Sierra-Lobo/backplane/revC1/doc/backplane-top.jpg

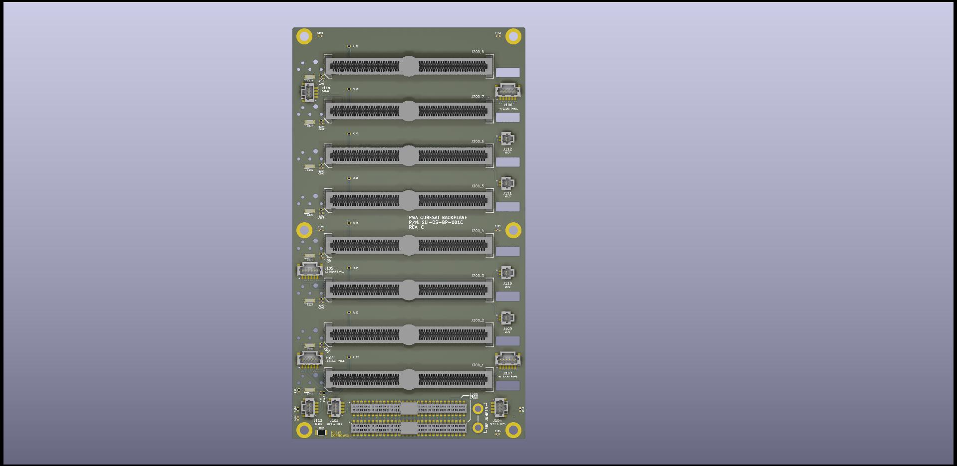
revC1/doc/backplane-top.jpg
