Sierra-Lobo/backplane/revC/pdf/backplane_brd.jpg

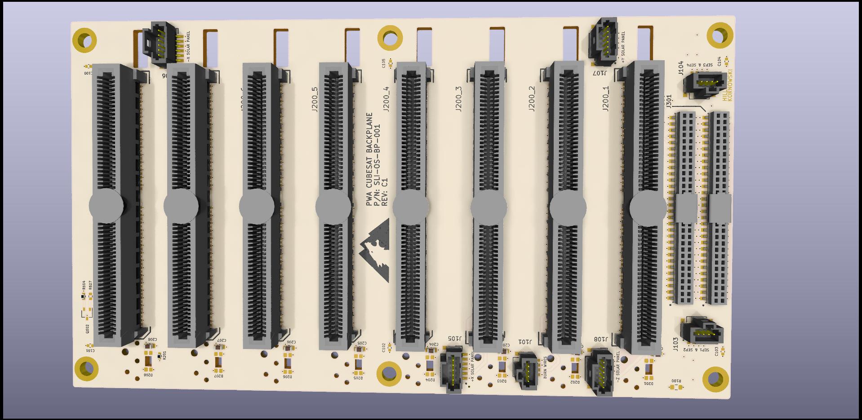
revC/pdf/backplane_brd.jpg
