Sierra-Lobo/backplane/README.md

# backplane

Sierra Lobo's 1.5U Cubesat Backplane
