Sierra-Lobo/backplane/revC/gerbers/settings.PNG

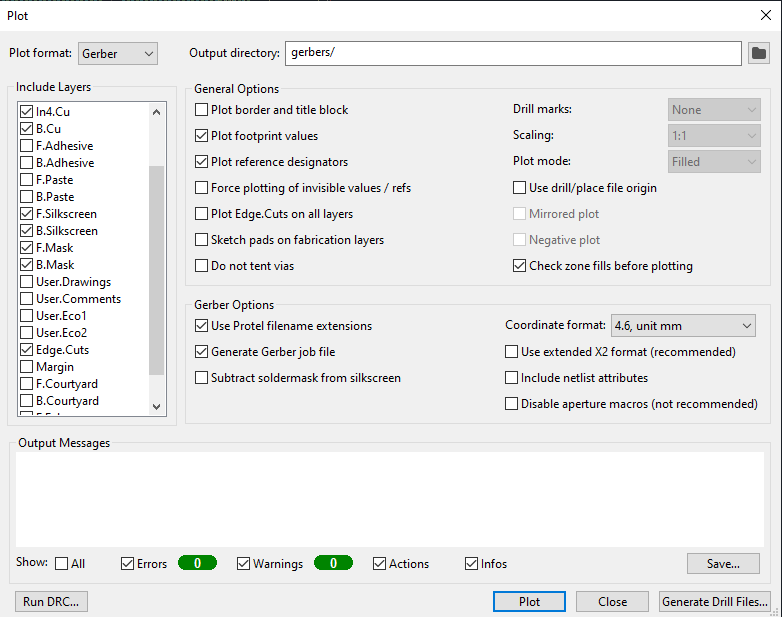
revC/gerbers/settings.PNG
