Sierra-Lobo/backplane/revC/gerbers/settings_drl.PNG

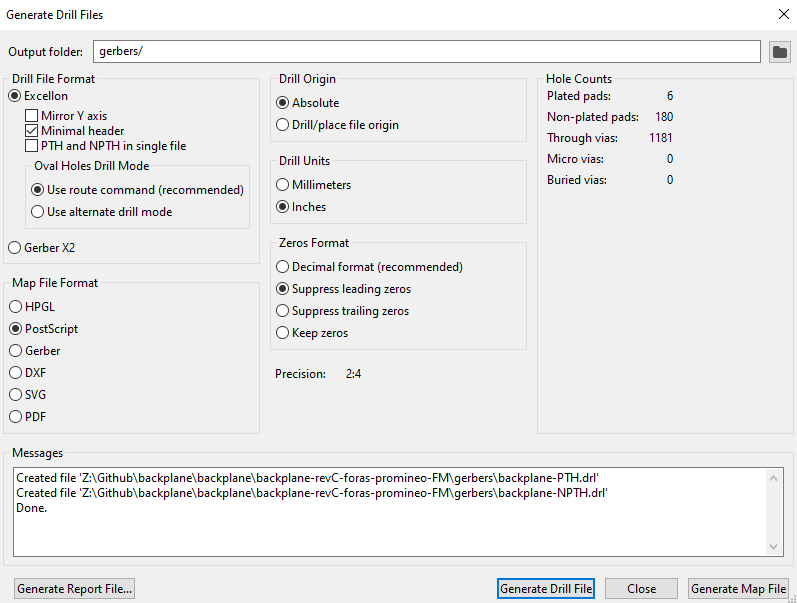
revC/gerbers/settings_drl.PNG
