Sierra-Lobo/backplane/revC1/doc/bom.xlsx

Date: | 2023-05-31
Components: | 69
Item | Qty | Designator | Description | LibPart | Footprint | Manufacturer | Manufacturer Part Number | DNP Flight | DNP Test | Populated By Vendor | Populated by SLI | Comment
1 | 1 |  | RBF Jumper | SierraLobo:BOMTIE |  | Keystone Electronics | 1430-2 |  |  |  | X
2 | 6 | C100, C101, C102, C103, C104, C105 | 10nF | backplane-rescue:C-Device | Capacitor_SMD:C_0402_1005Metric | TDK | CGA2B3X7S2A103K050BB |  |  | X
3 | 8 | C201, C202, C203, C204, C205, C206, C207, C208 | 0.1uF | Device:C | Capacitor_SMD:C_0402_1005Metric | TDK | CGA2B3X7R1E104K050BB |  |  | X
4 | 8 | D201, D202, D203, D204, D205, D206, D207, D208 |  | CubeSat_Backplane:SK68xx | SierraLobo:SK68xx-EC120x_ReverseMount | Adafruit | SK6812-EC321F |  |  |  | X | reverse mounted
5 | 4 | J103, J104, J113, J114 |  | Connector_Generic:Conn_01x04 | SierraLobo:SAMTEC_T1M-04-F-SV-L | Samtec | T1M-04-F-SV-L |  |  | X
6 | 4 | J105, J106, J107, J108 |  | Connector_Generic:Conn_01x06 | SierraLobo:SAMTEC_T1M-06-F-SV-L | Samtec | T1M-06-F-SV-L |  |  | X
7 | 4 | J109, J110, J111, J112 |  | Connector_Generic:Conn_01x02 | SierraLobo:SAMTEC_T1M-02-F-SV-L-P | Samtec | T1M-02-F-SV-L |  |  | X
8 | 8 | J200_1, J200_2, J200_3, J200_4, J200_5, J200_6, J200_7, J200_8 |  | CubeSat_Backplane:Conn_02x60_Top_Bottom | SierraLobo:HTEC8-160-01-S-DV-A-K-TR | Samtec | HTEC8-160-01-L-DV-A |  |  | X
9 | 2 | J300, J301 |  | backplane-rescue:Conn_02x30_Odd_Even-Connector_Generic | SierraLobo:SAMTEC_CLP-130-02-X-D-BE-A-P-TR | Samtec | CLP-130-02-X-D-BE-A-P-TR |  |  |  | X
10 | 2 | P100, P101 |  | Connector_Generic:Conn_01x01 | SierraLobo:MilMax_0640-0 | MilMax | 0640-0-15-15-48-27-10-0 |  |  |  | X | Press fit mounted
11 | 1 | R100 | 0R | backplane-rescue:R_US-Device | Resistor_SMD:R_1206_3216Metric | Keystone Electronics | Keystone 5108 |  |  | X
12 | 11 | R101, R102, R103, R104, R105, R106, R107, R108, R109, R111, R112 | 0R | backplane-rescue:R_US-Device | Resistor_SMD:R_0402_1005Metric | Panasonic | ERJ-2GE0R00X | R111, R112 |  | X
13 | 8 | R203, R204, R205, R206, R207, R208, R209, R210 | 1k | :R_US-Device_1 | Resistor_SMD:R_0402_1005Metric | Panasonic | ERJ-2GEJ102X | R210 |  | X
14 | 2 | SW100, SW101 | RESET | backplane-rescue:SW_Push-Switch | SierraLobo:KMT031_NGJ_LHS | C&K | KMT031NGJLHS |  |  | X
