Sierra-Lobo/backplane/revC/bom/backplane_bom.xlsx

Item | Qty | Reference(s) | Value | Part Number | Mfr | Note
1 | 6 | C100, C101, C102, C103, C104, C105 | 0.1uF 0402 | C0402C104M4RACAUTO | KEMET
2 | 8 | C201, C202, C203, C204, C205, C206, C207, C208 | 1uF 0603 | C0603C105K8RACAUTO | KEMET
3 | 8 | D201, D202, D203, D204, D205, D206, D207, D208 | RGB LED 3210 | SK68XX-EC3210R | Adafruit | mount upside-down
4 | 3 | J101, J103, J104 | Conn 4 pos | T1M-04-F-SV-L | Samtec
5 | 4 | J105, J106, J107, J108 | Conn 6 pos | T1M-06-F-SV-L | Samtec
6 | 8 | J200_1, J200_2, J200_3, J200_4, J200_5, J200_6, J200_7, J200_8 | Card Edge Connector, 120 | HSEC8-160-01-S-DV-A-K-TR | Samtec
7 | 2 | J300, J301 | Header 30x2 | CLP-130-02-X-D-BE-A-P-TR | Samtec
8 | 2 | Q602, Q603 | PNP SOT323 | BC857AW,115 | Nexperia
9 | 1 | R100 | 0mR | RC0603JR-070RL | YAEGO | DNP
10 | 1 | R201 | 330R | RMCF0402JT330R | YAEGO
11 | 1 | R604 | 0R | RMCF0402ZT0R00 | YAEGO
12 | 2 | R607, R609 | 4.7k | RMCF0402FT4K70 | YAEGO
13 | 1 | R608 | 10k | RMCF0402FT10K0 | YAEGO
14 | 2 | SW100, SW101 | SMT SW | KMT031NGJLHS | C&K
