Sierra-Lobo/backplane/revC/fabrication-data/PCBway-TZ28W422300A-2sets-backplane_bom(2022-05-12).xls

PCBWay Bom Quotation, Product No.:T-Z28W422300A
Item # | *Designator | *Qty | Manufacturer | *Mfg Part # | Description / Value | *Package/Footprint | Your Instructions / Notes | *Unit Price(2 sets) | *Total | *Delivery Time | *PCBWay Note | Customer Reply | PCBWay Update
1 | C100,C101,C102,C103,C104,C105 | 6 | KEMET | C0402C104M4RACAUTO | 0.1uF | 0402（1005 metric） |  | $0.140 | $1.680
2 | C201,C202,C203,C204,C205,C206,C207,C208 | 8 | KEMET | C0603C105K8RACAUTO | 1uF | 0603（1608 metric） |  | $0.138 | $2.208
3 | D201,D202,D203,D204,D205,D206,D207,D208 | 8 |  | SK68XX-EC3210R |  |  | mount upside-down |  |  |  | [It's out of stock. Please recommend substitutes or you can supply this part to us.] | Do not place
4 | J101,J103,J104 | 3 | Samtec Inc. | T1M-04-F-SV-L |  |  |  | $4.094 | $24.564 | 7-10 Workdays
5 | J105,J106,J107,J108 | 4 | Samtec Inc. | T1M-06-F-SV-L |  |  |  | $8.161 | $65.288 | 15 Workdays
6 | J200_1,J200_2,J200_3,J200_4,J200_5,J200_6,J200_7,J200_8 | 8 | Samtec Inc. | HSEC8-160-01-S-DV-A-K-TR |  |  |  | $9.290 | $148.640 | 7-10 Workdays
7 | J300,J301 | 2 | Samtec Inc. | CLP-130-02-X-D-BE-A-P-TR |  |  |  |  |  |  | [It's out of stock. Please recommend substitutes or you can supply this part to us.] | Do not place
8 | Q602,Q603 | 2 | Nexperia USA Inc. | BC857AW,115 |  | SC-70，SOT-323 |  | $0.232 | $0.928 | 7-10 Workdays
9 | R100 | 1 | YAGEO | RC0603JR-070RL | 0mR | 0603（1608 metric） | DNP | $0.069 | $0.138
10 | R201 | 1 | Stackpole Electronics Inc | RMCF0402JT330R | 330R | 0402（1005 metric） |  | $0.069 | $0.138
11 | R604 | 1 | Stackpole Electronics Inc | RMCF0402ZT0R00 | 0R | 0402（1005 metric） |  | $0.069 | $0.138
12 | R607,R609 | 2 | Stackpole Electronics Inc | RMCF0402FT4K70 | 4.7k | 0402（1005 metric） |  | $0.058 | $0.232
13 | R608 | 1 | Stackpole Electronics Inc | RMCF0402FT10K0 | 10k | 0402（1005 metric） |  | $0.069 | $0.138
14 | SW100,SW101 | 2 | C&K | KMT031NGJLHS |  |  |  | $1.575 | $6.300
 |  |  |  |  |  |  |  | All Total | $250.392
