Sierra-Lobo/backplane/backplane-boards/backplane-breakout-big/backplane-breaout-big.step

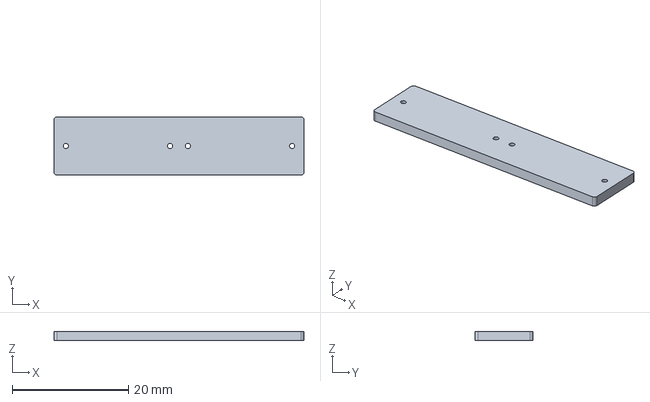
[picture p5: CAD file, 2021-12-19]
backplane-boards/backplane-breakout-big/backplane-breaout-big.step
43.0 x 10.0 x 1.60 mm
