Sierra-Lobo/backplane/revC/solid models/SAMTEC-FTS-130-03-X-DV.step

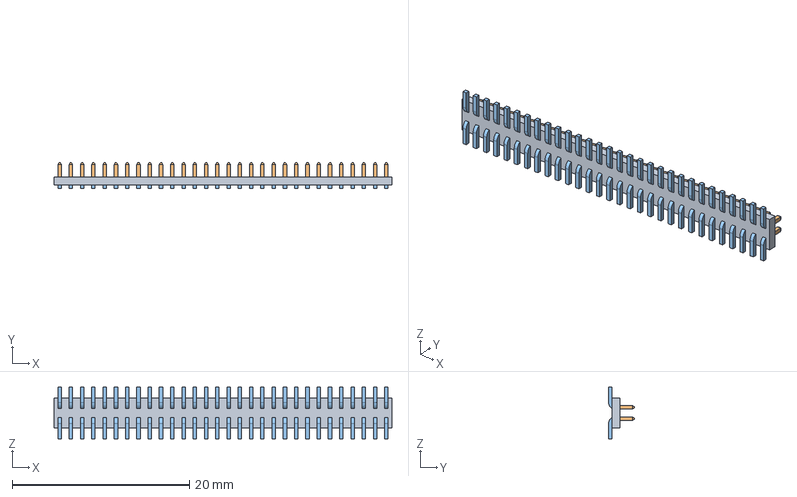
[picture p6: CAD file, 2021-12-21]
revC/solid models/SAMTEC-FTS-130-03-X-DV.step
38.1 x 2.92 x 5.84 mm
_FTS-130-03-L-DV_body
_FTS-130-03-L-DV_pins1
_FTS-130-03-L-DV_pins2
