Sierra-Lobo/backplane/solid models/backplane.step

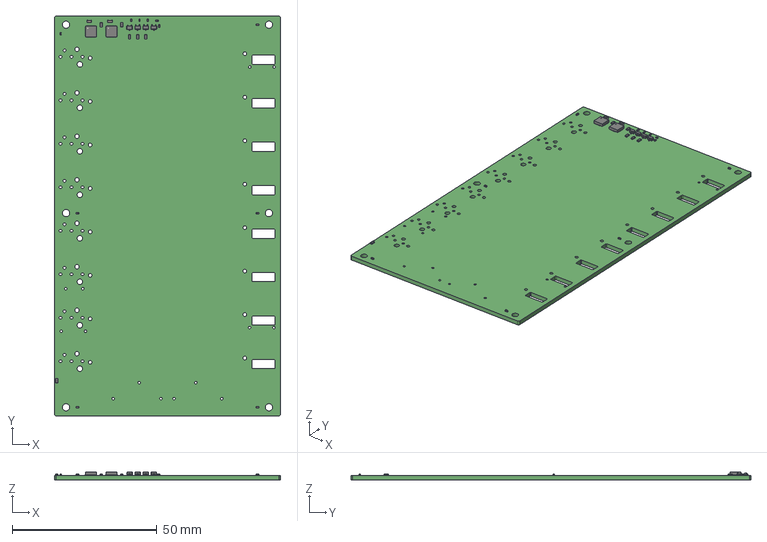
[picture p7: CAD file, 2021-12-17]
solid models/backplane.step
78.0 x 138.0 x 2.75 mm
