Sierra-Lobo/backplane/revC/fabrication-data/AA B110353 ER.xlsx

BOM LINE | MFG PN | ISSUE | RESOLUTION
7 | CLP-130-02-X-D-BE-A-P-TR | Please confirm PN, stock not found | We can supply these
5 | T1M-06-F-SV-L | 89 days lead time. | substitute T1M-06-F-SV-L-P please.
 | SUB APPROVAL REQUIRED
BOM LINE | MFG PN | SUGGESTED ALT | ALT LT IF APPLICABLE | RESOLUTION
3 | SK68XX-EC3210R | 4893 | 14 days lead time. | DNP please
