Sierra-Lobo/backplane/revB/fabrication-data/backplane_log.xlsx

Sheet: Changes too
Make manufacturer put no solder on unused pads
Make manufacturer assemble all parts even if we have to cosign them, these boards are challenging to assemble
make sure J300, J301 are placed next time
Move R100 farther from board edge

Sheet: FP-P-01
Board Location: | SLI TDEC in Foras Promineo ESD tote
Date | Action | Comment | Date | Todo | Comment
2022-02-16 | Received |  | 2022-02-17
2022-02-17 | Removed all unused pads’ solder
2022-02-17 | Failed solder J300, removed it and ordered more

Sheet: FP-P-02
Board Location: | Caden
Date | Action | Comment | Date | Todo | Comment
2022-02-16 | Received |  | 2022-02-17
2022-02-17 | Removed all unused pads’ solder
2022-02-17 | Soldered on J300, J301 but rear mount header (part of backplane breakout connector) was used to allign it and was also soldered to the board.
