Sierra-Lobo/backplane/revB/fabrication-data/PCBway/W422300AS1J11.xls

Sheet: EQs
EQ
ITEM | QUESTION | ADVICE | PICTURE | REPLY | REMARK
1 | Attention 1.jpg,please confirm if the stackup information is OK. | ok | 1.jpg | OK
2 | Attention 2.jpg,two files at the arrow cannot be opened, please confirm | Ignore these 2 files,tolerance for all PTH holes: +/-3mil; NPTH hole tolerance: +/-2mil,OK? | 2.jpg | OK
3 | Please confirm if the attached working file is OK. | ok |  | OK

Sheet: 1.jpg
返回（Return） EQs

Sheet: 2.jpg
返回（Return） EQs
