Sierra-Lobo/backplane/(threads)

Thread 1 (2021-12-17):

add burn wire connectors

cadenhillis, 2021-12-17:

cadenhillis, 2022-05-10:
see RevC :)

Closed 2022-05-10.
