Sierra-Lobo/backplane/revC1/doc/backplane_assy.pdf

R209 | R109 C²⁰¹ C203
R210 R²⁰³ | R103

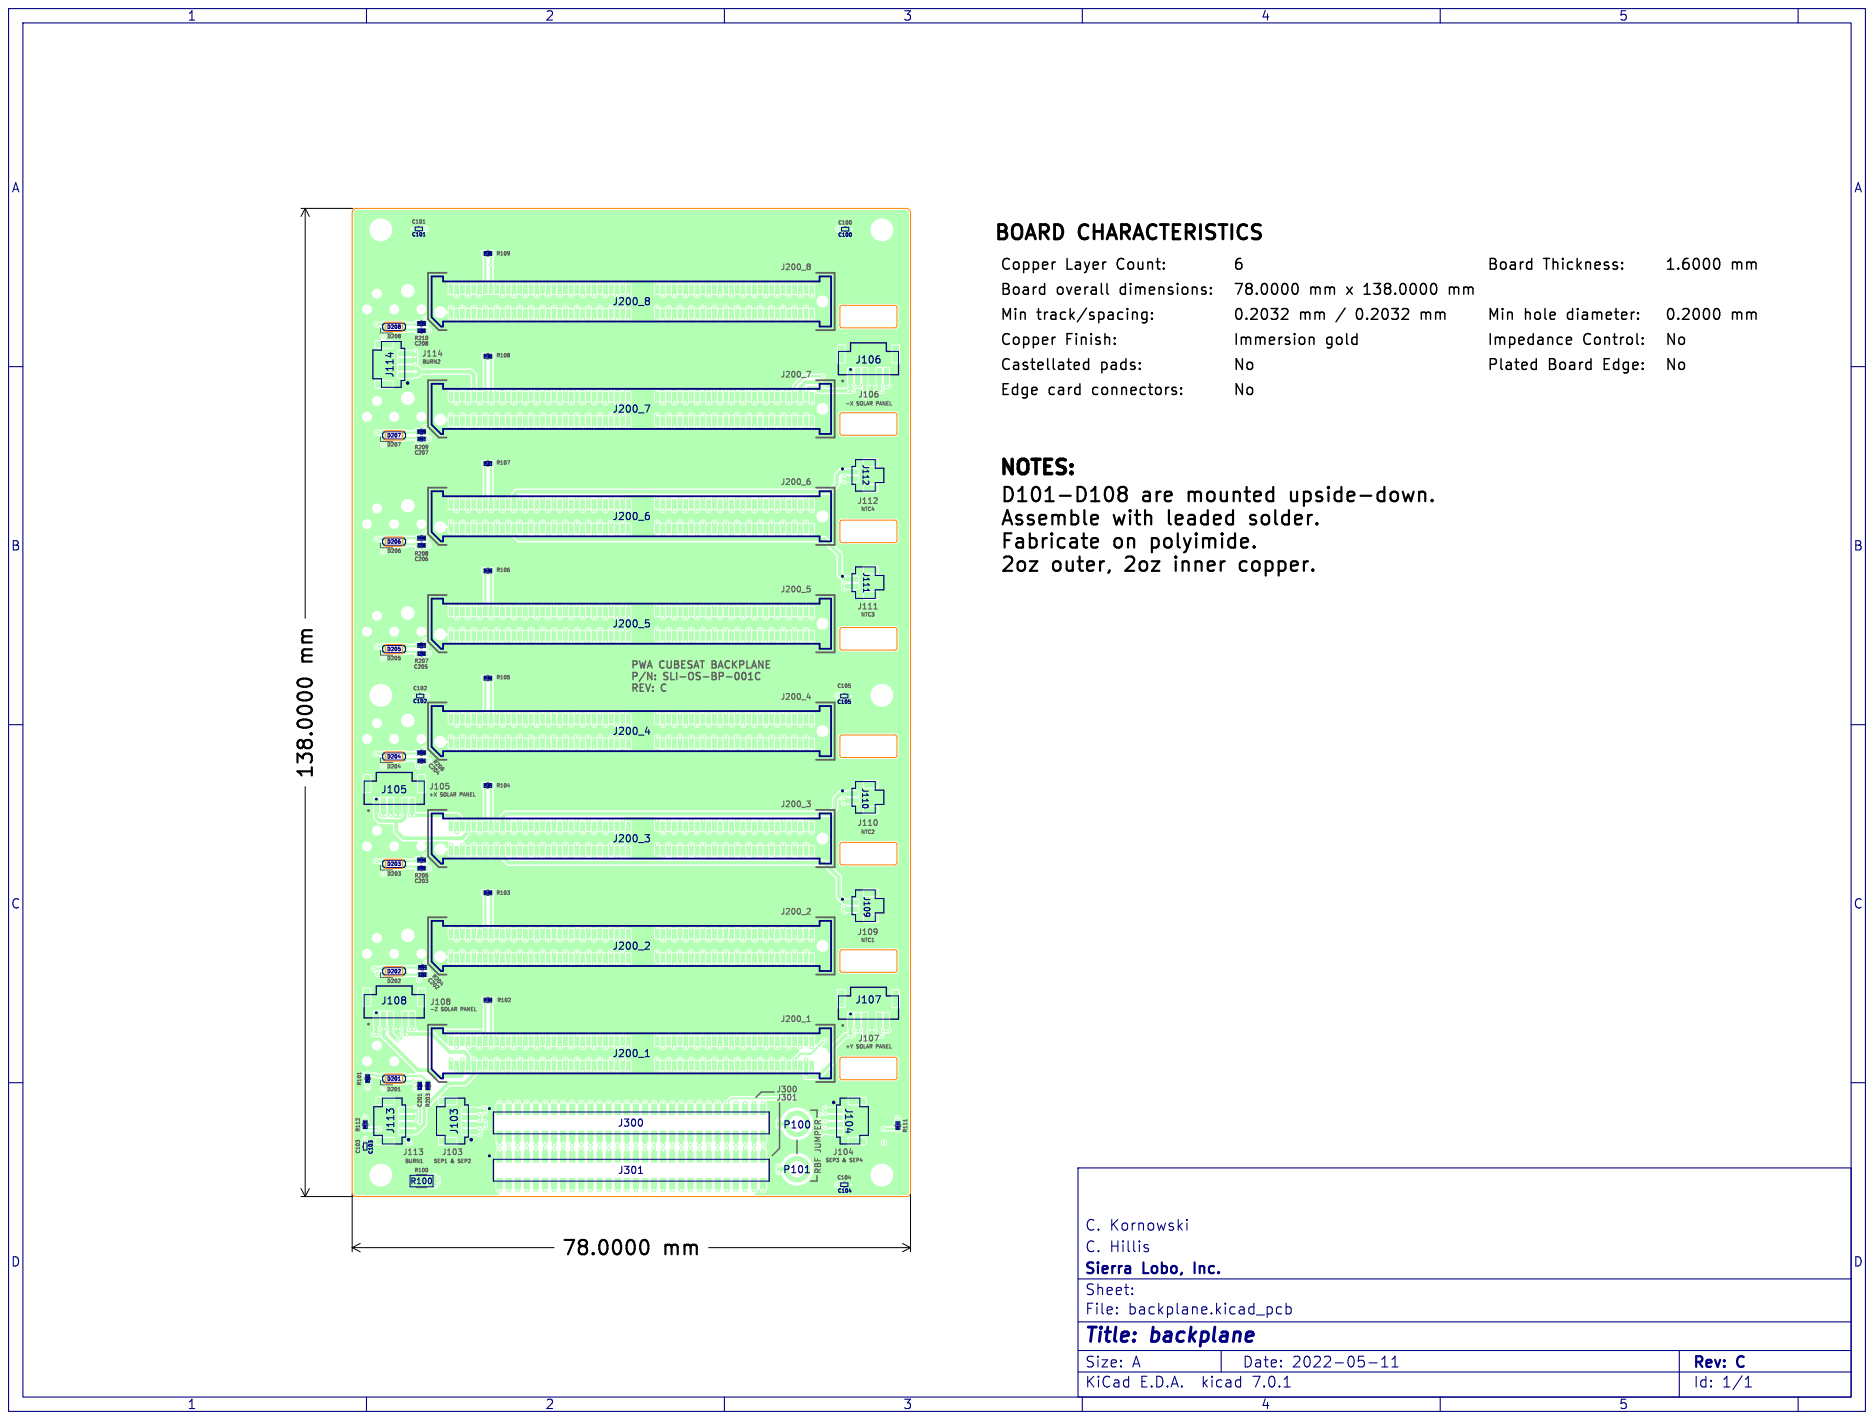
[picture p8: page 1]

File: backplane.kicad_pcb Sheet: Sierra Lobo, Inc. C. Hillis C. Kornowski J110 J109 J112 J111

2oz outer, 2oz inner copper. 138.0000 mm

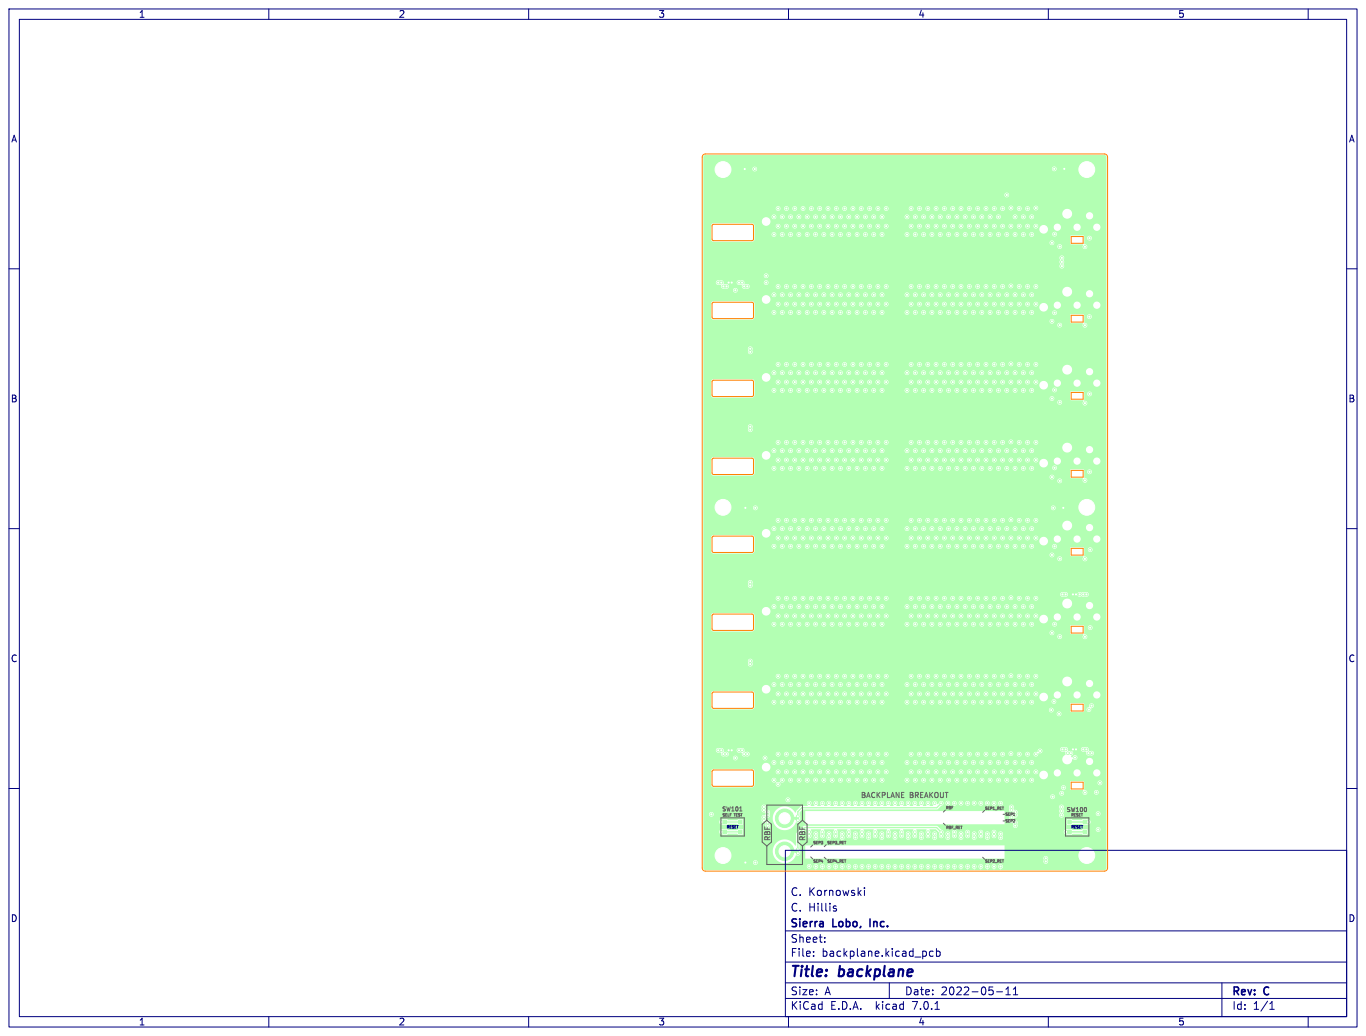
[picture p9: page 2]
D Date: 2022-05-11 KiCad; kicad; 7.0.1 Size: A; Rev: C; File:; backplane.kicad_pcb Sheet: Sierra; Lobo,; Inc. C.; Hillis C.; Kornowski RESET; RESET

Id: 1/1 Title: backplane
