Sierra-Lobo/backplane/revC/pdf/backplane-sch.pdf

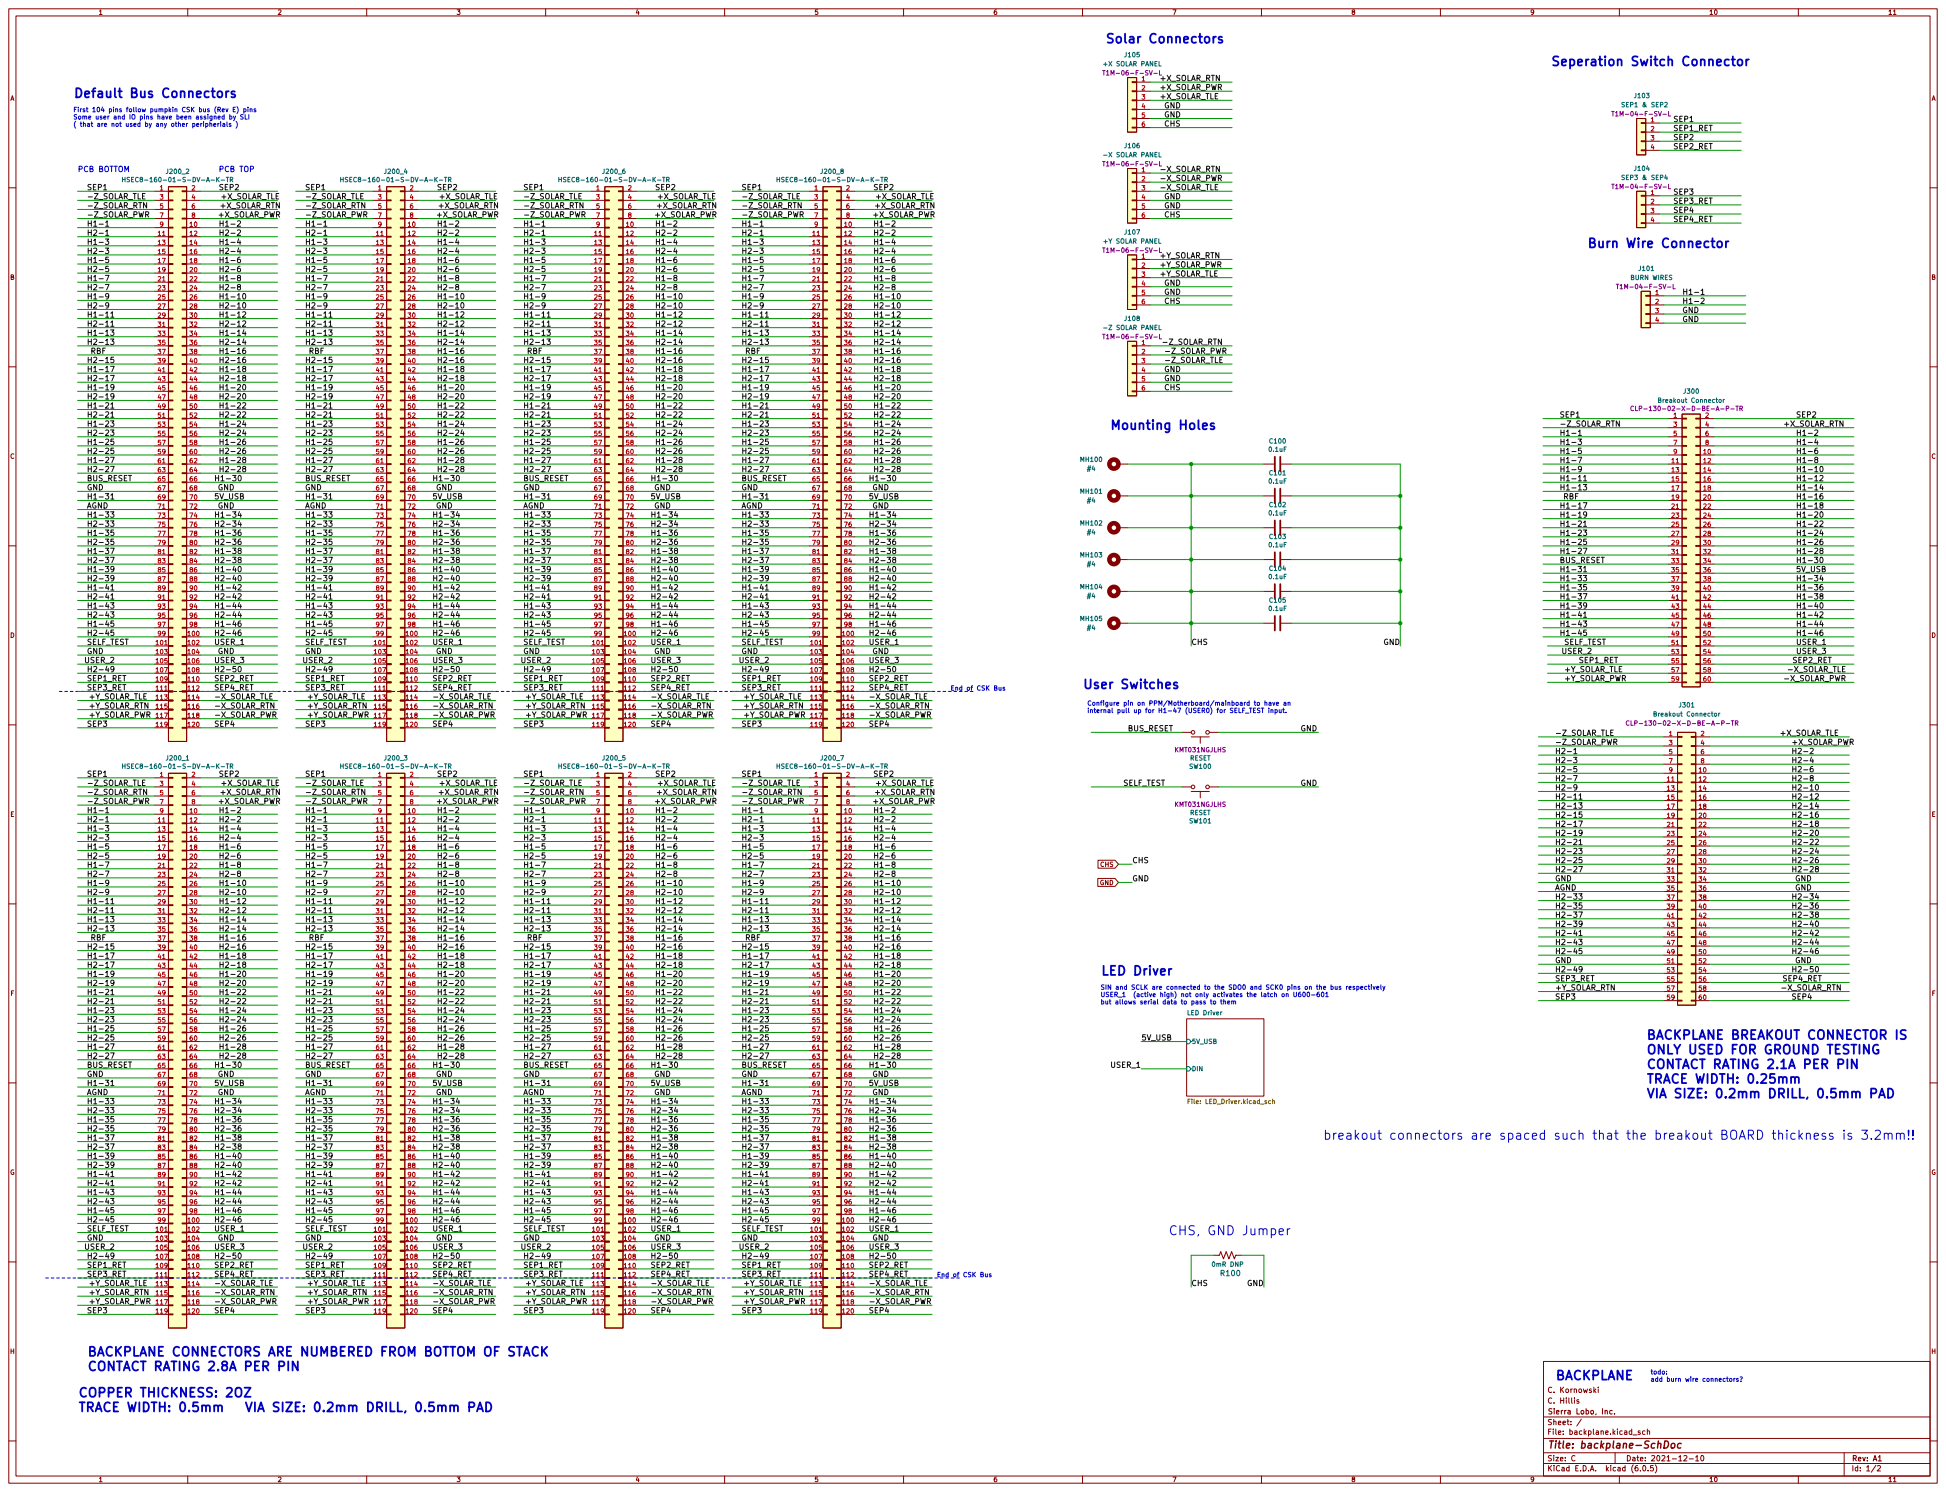
[picture p10: page 1]

First 104 pins follow pumpkin CSK bus (Rev E) pins
Some user and IO pins have been assigned by SLI
( that are not used by any other peripherials )

J300 Breakout Connector CLP-130-02-X-D-BE-A-P-TR
H1-1 H1-5 H1-41 H1-37 H1-43 H1-27 H1-31 BUS_RESET H1-45 H1-39 SELF_TEST H1-25 H1-19SEP1_RET

Configure pin on PPM/Motherboard/mainboard to have an
internal pull up for H1-47 (USER0) for SELF_TEST input.

J301 Breakout Connector CLP-130-02-X-D-BE-A-P-TR R100

SIN and SCLK are connected to the SDO0 and SCK0 pins on the bus respectively
USER_1 (active high) not only activates the latch on U600-601
but allows serial data to pass to them

BACKPLANE BREAKOUT CONNECTOR IS
ONLY USED FOR GROUND TESTING
CONTACT RATING 2.1A PER PIN
TRACE WIDTH: 0.25mm
VIA SIZE: 0.2mm DRILL, 0.5mm PAD

breakout connectors are spaced such that the breakout BOARD thickness is 3.2mm!!

BACKPLANE CONNECTORS ARE NUMBERED FROM BOTTOM OF STACK
CONTACT RATING 2.8A PER PIN
COPPER THICKNESS: 2OZ
TRACE WIDTH: 0.5mm VIA SIZE: 0.2mm DRILL, 0.5mm PAD

File: backplane.kicad_sch Sheet: / Sierra Lobo, Inc. C. Hillis C. Kornowski

Id: 1/2 Title: backplane-SchDoc

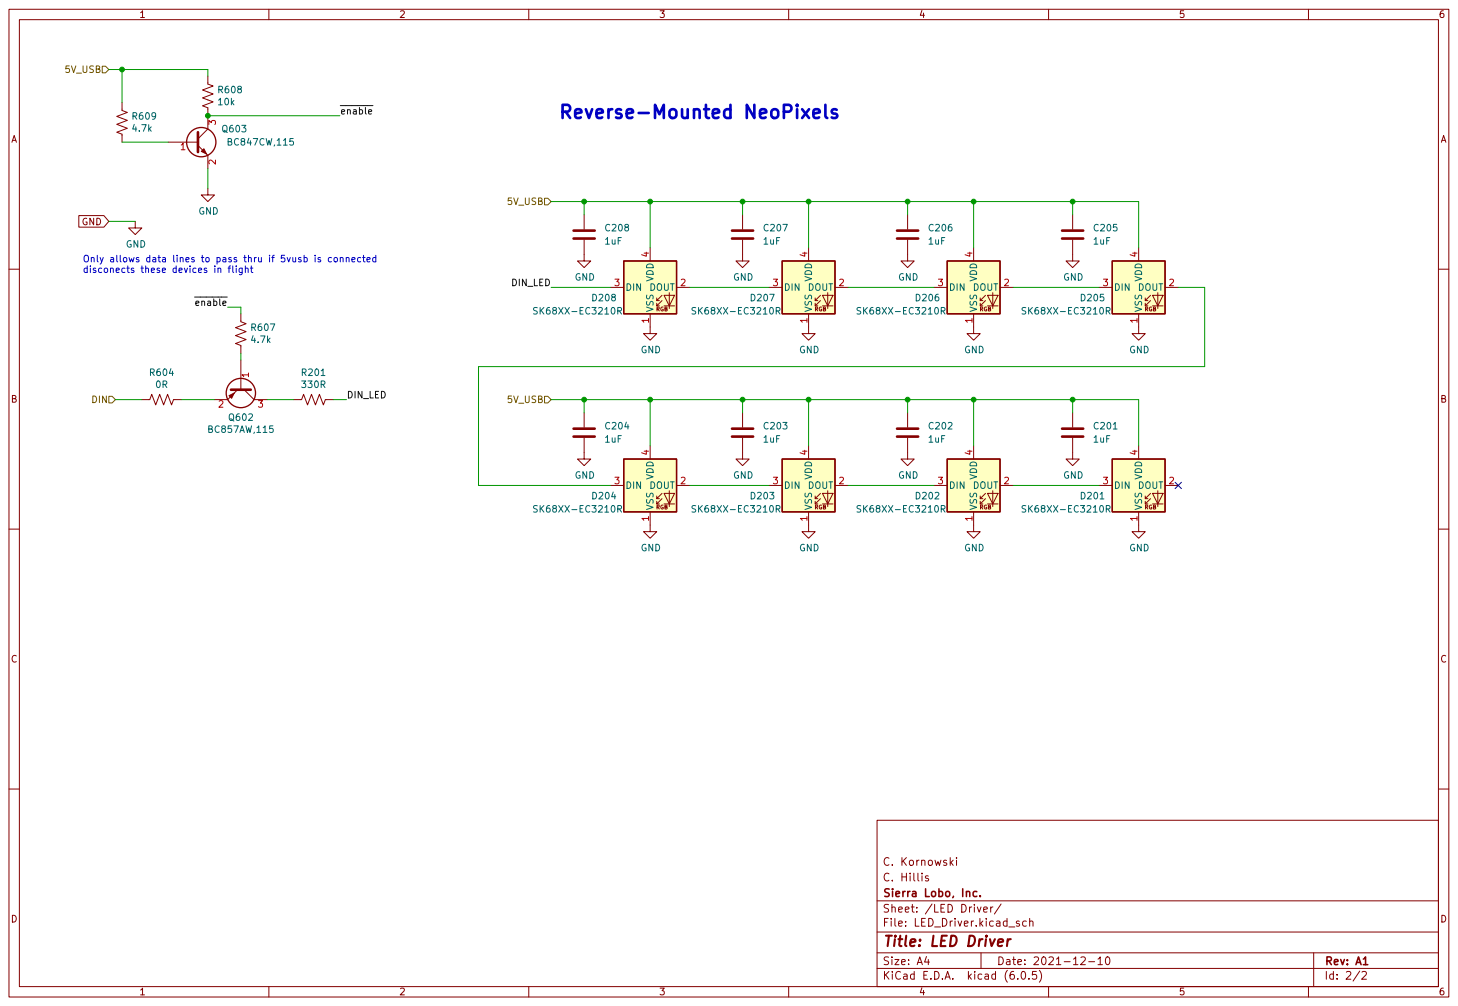
[picture p11: page 2]

DIN_LED Only allows data lines to pass thru if 5vusb is connected
disconects these devices in flight

4 D208 SK68XX-EC3210R VSS RGB 1 DOUT 2 DIN 3 VDD

4 D204 SK68XX-EC3210R GND GND GND VSS RGB 1 DOUT 2 DIN 3 VDD

4 D202 SK68XX-EC3210R GND VSS RGB 1 DOUT 2 DIN 3 VDD

4 D203 SK68XX-EC3210R VSS RGB 1 DOUT 2 DIN 3 VDD

Id: 2/2 Title: LED Driver
