Sierra-Lobo/backplane/revC1/doc/backplane-sch.pdf

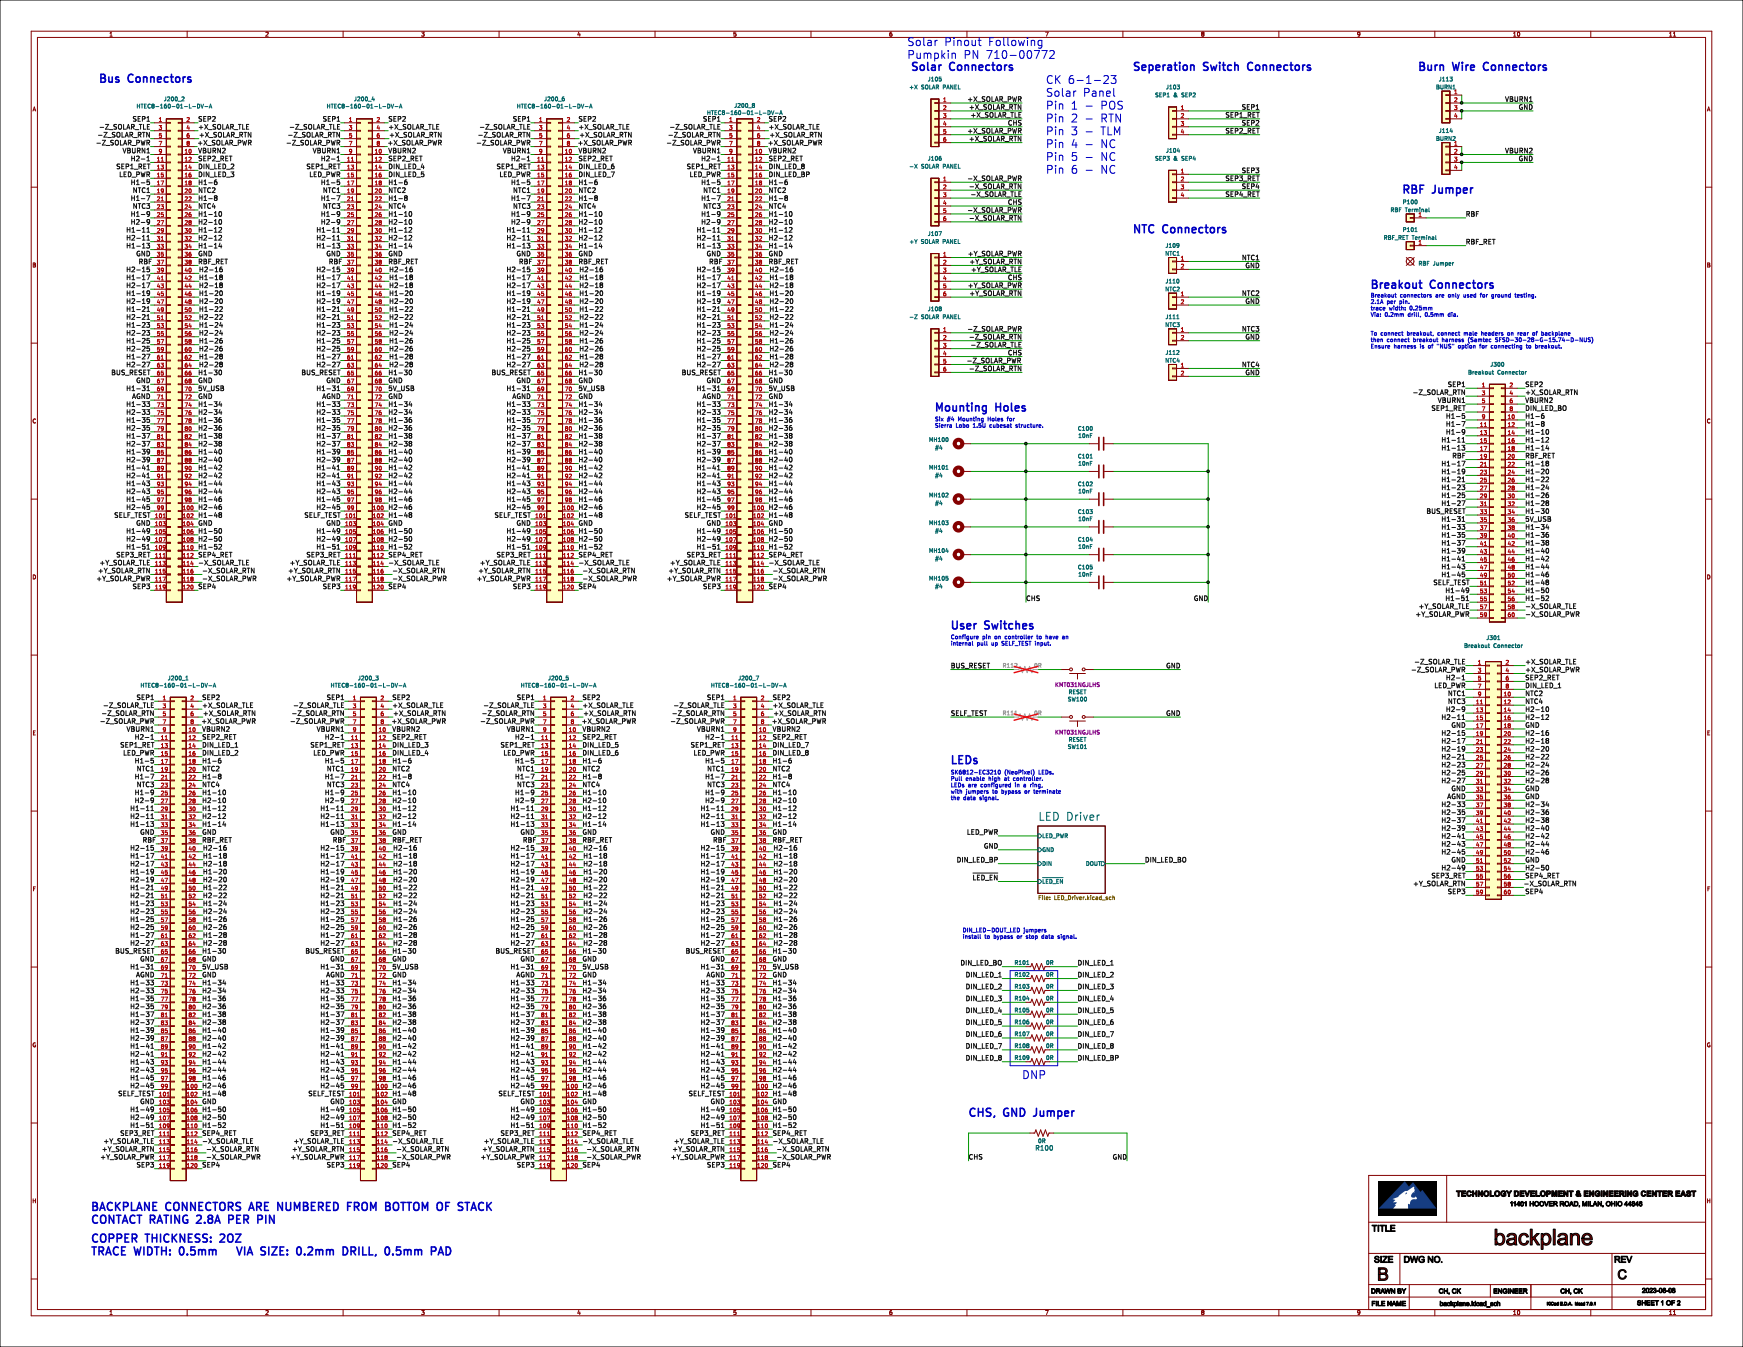
[picture p12: page 1]

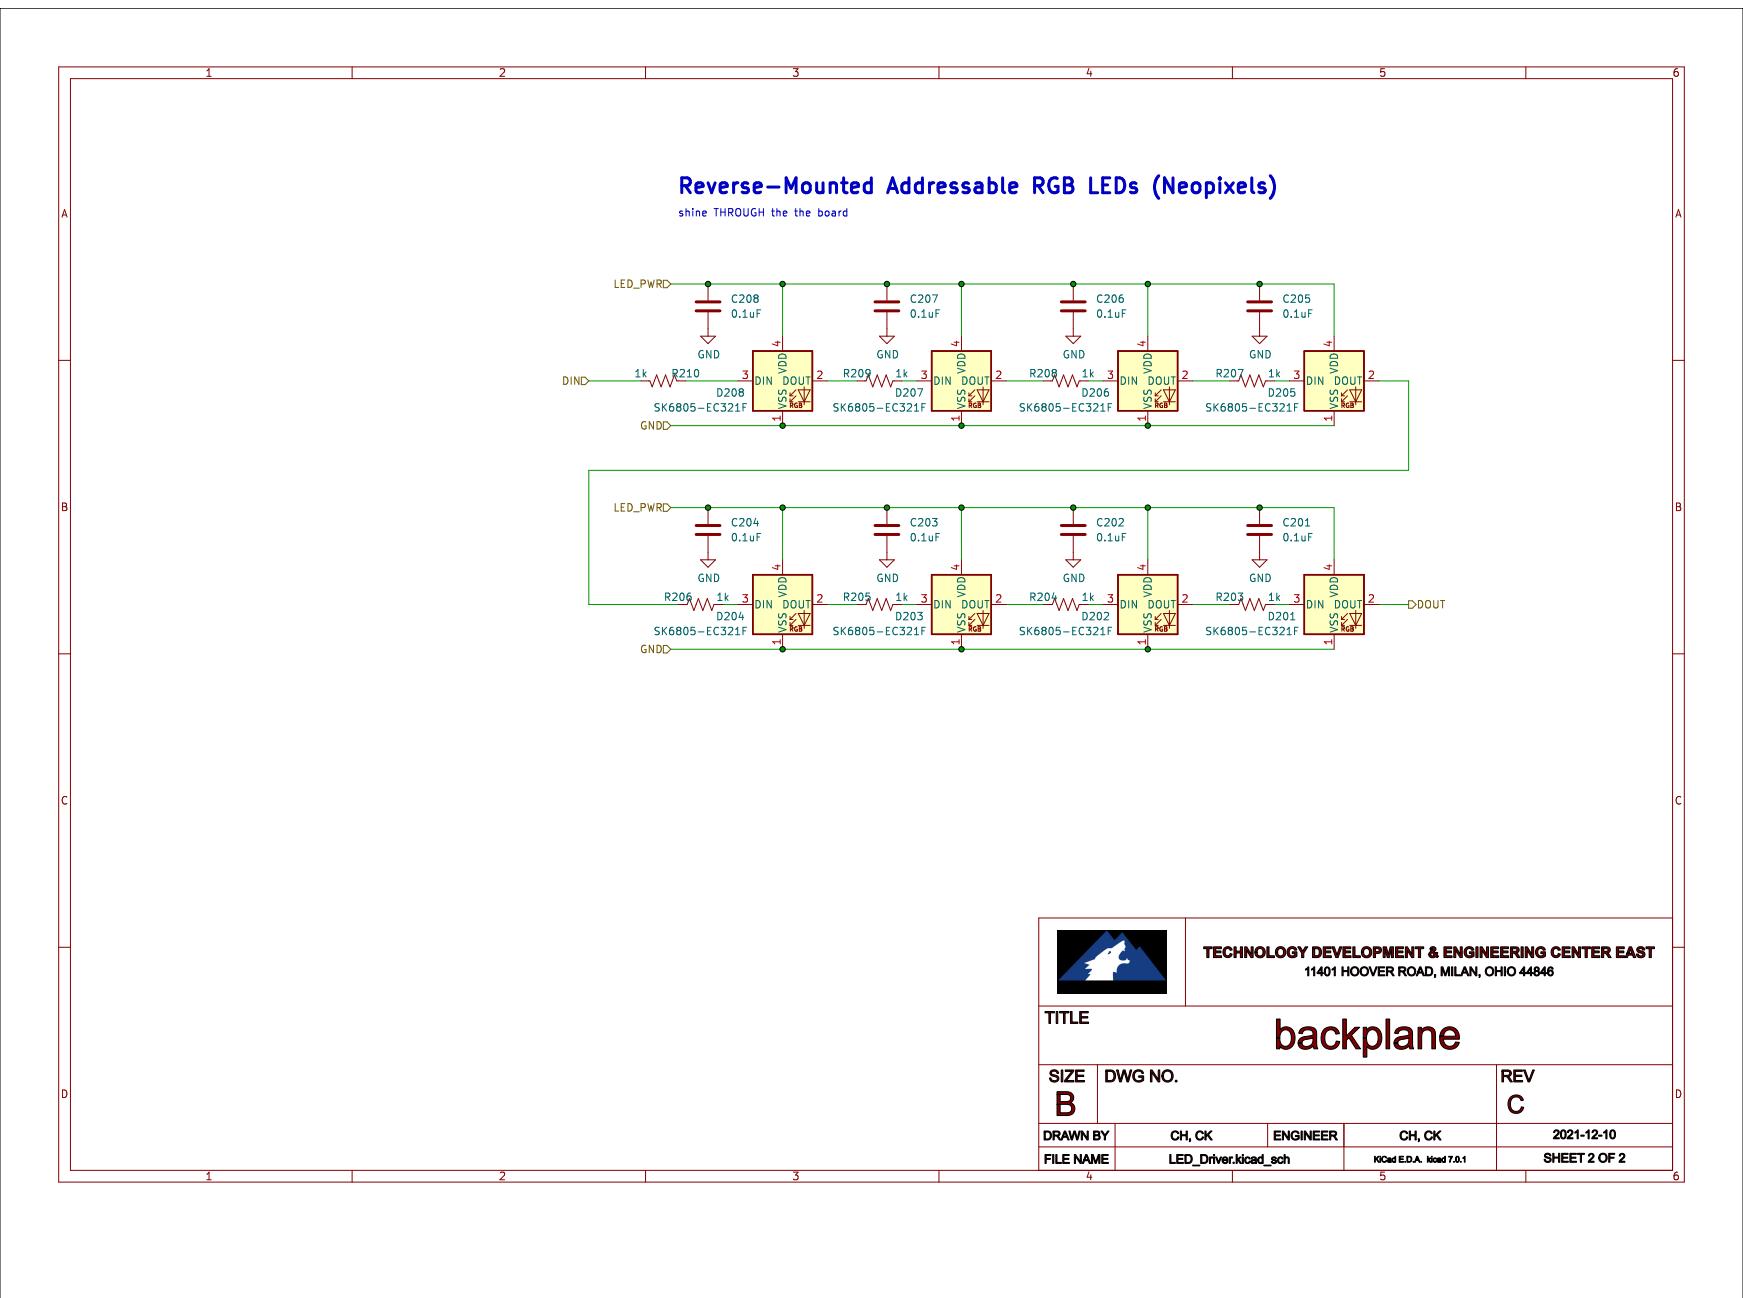
[picture p13: page 2]
