Sierra-Lobo/backplane/revC/pdf/backplane-brd.pdf

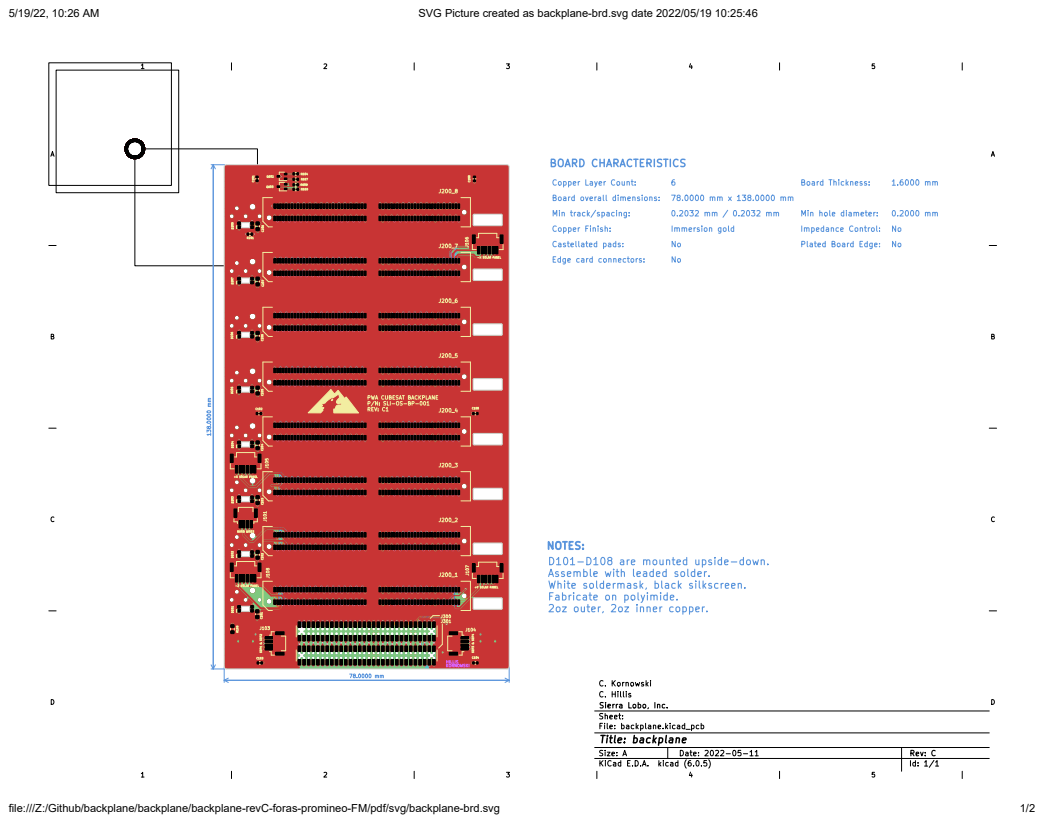
[picture p14: page 1]
SVG Picture created as backplane-brd.svg date 2022/05/19 10:25:46; file:///Z:/Github/backplane/backplane/backplane-revC-foras-promineo-FM/pdf/svg/backplane-brd.svg
