Sierra-Lobo/backplane/revB/pdf/backplane.pdf

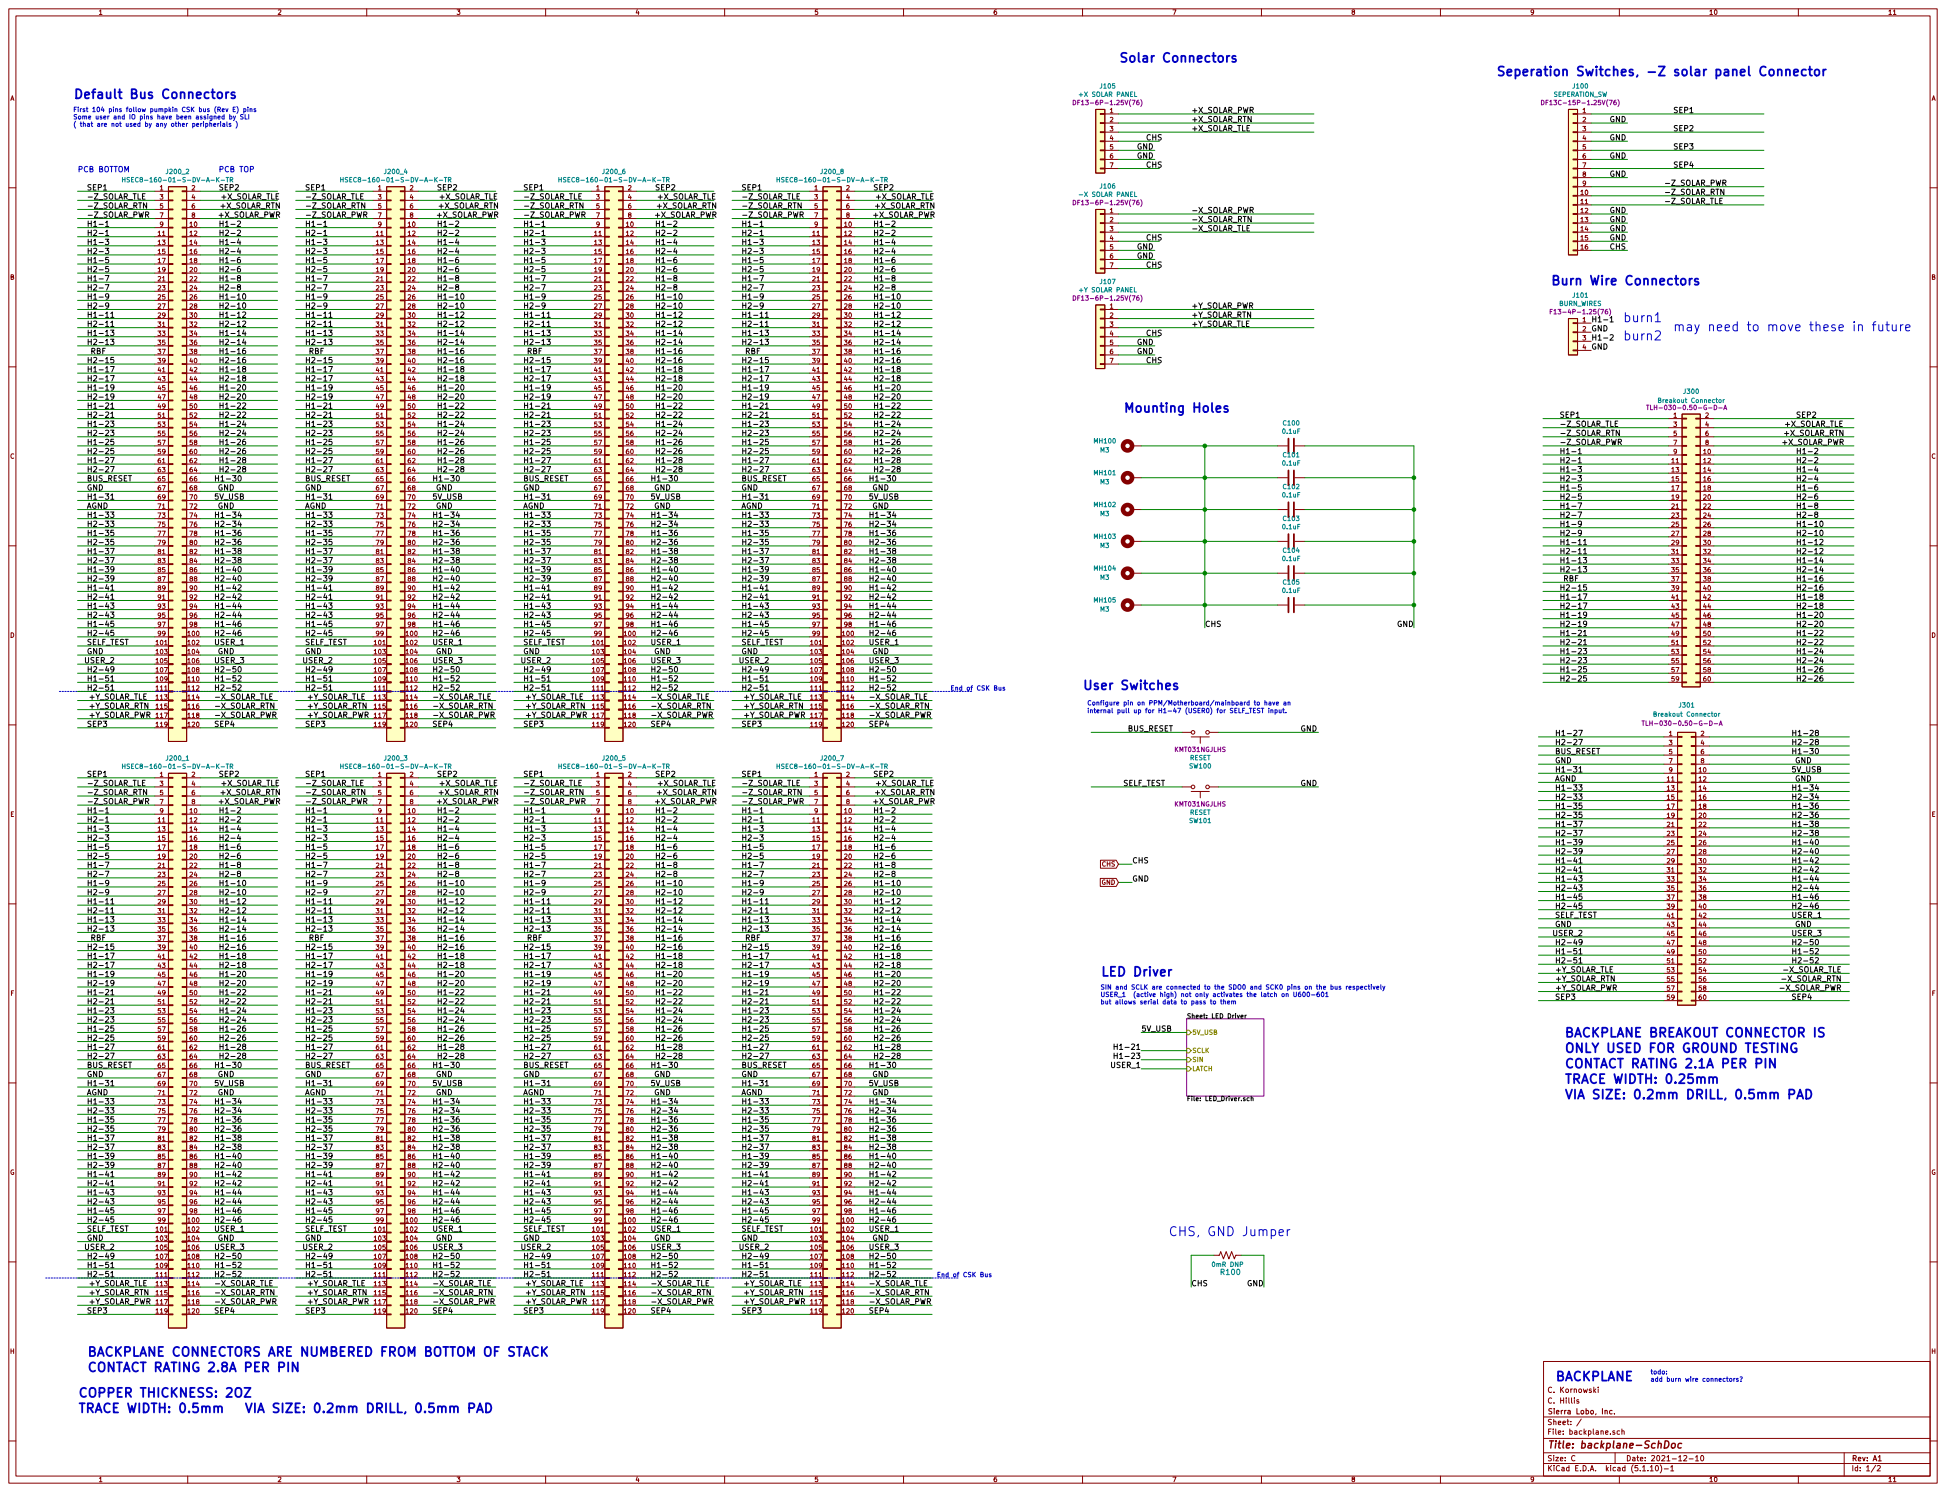
[picture p15: page 1]

Seperation Switches, -Z solar panel Connector

First 104 pins follow pumpkin CSK bus (Rev E) pins
Some user and IO pins have been assigned by SLI
( that are not used by any other peripherials )

may need to move these in future

End of CSK Bus

Configure pin on PPM/Motherboard/mainboard to have an
internal pull up for H1-47 (USER0) for SELF_TEST input.

SIN and SCLK are connected to the SDO0 and SCK0 pins on the bus respectively
USER_1 (active high) not only activates the latch on U600-601
but allows serial data to pass to them

Sheet: LED Driver File: LED_Driver.sch

BACKPLANE BREAKOUT CONNECTOR IS
ONLY USED FOR GROUND TESTING
CONTACT RATING 2.1A PER PIN
TRACE WIDTH: 0.25mm
VIA SIZE: 0.2mm DRILL, 0.5mm PAD

BACKPLANE CONNECTORS ARE NUMBERED FROM BOTTOM OF STACK
CONTACT RATING 2.8A PER PIN
COPPER THICKNESS: 2OZ
TRACE WIDTH: 0.5mm VIA SIZE: 0.2mm DRILL, 0.5mm PAD

todo: BACKPLANE add burn wire connectors?

File: backplane.sch Sheet: / Sierra Lobo, Inc. C. Hillis C. Kornowski

Id: 1/2 Title: backplane-SchDoc

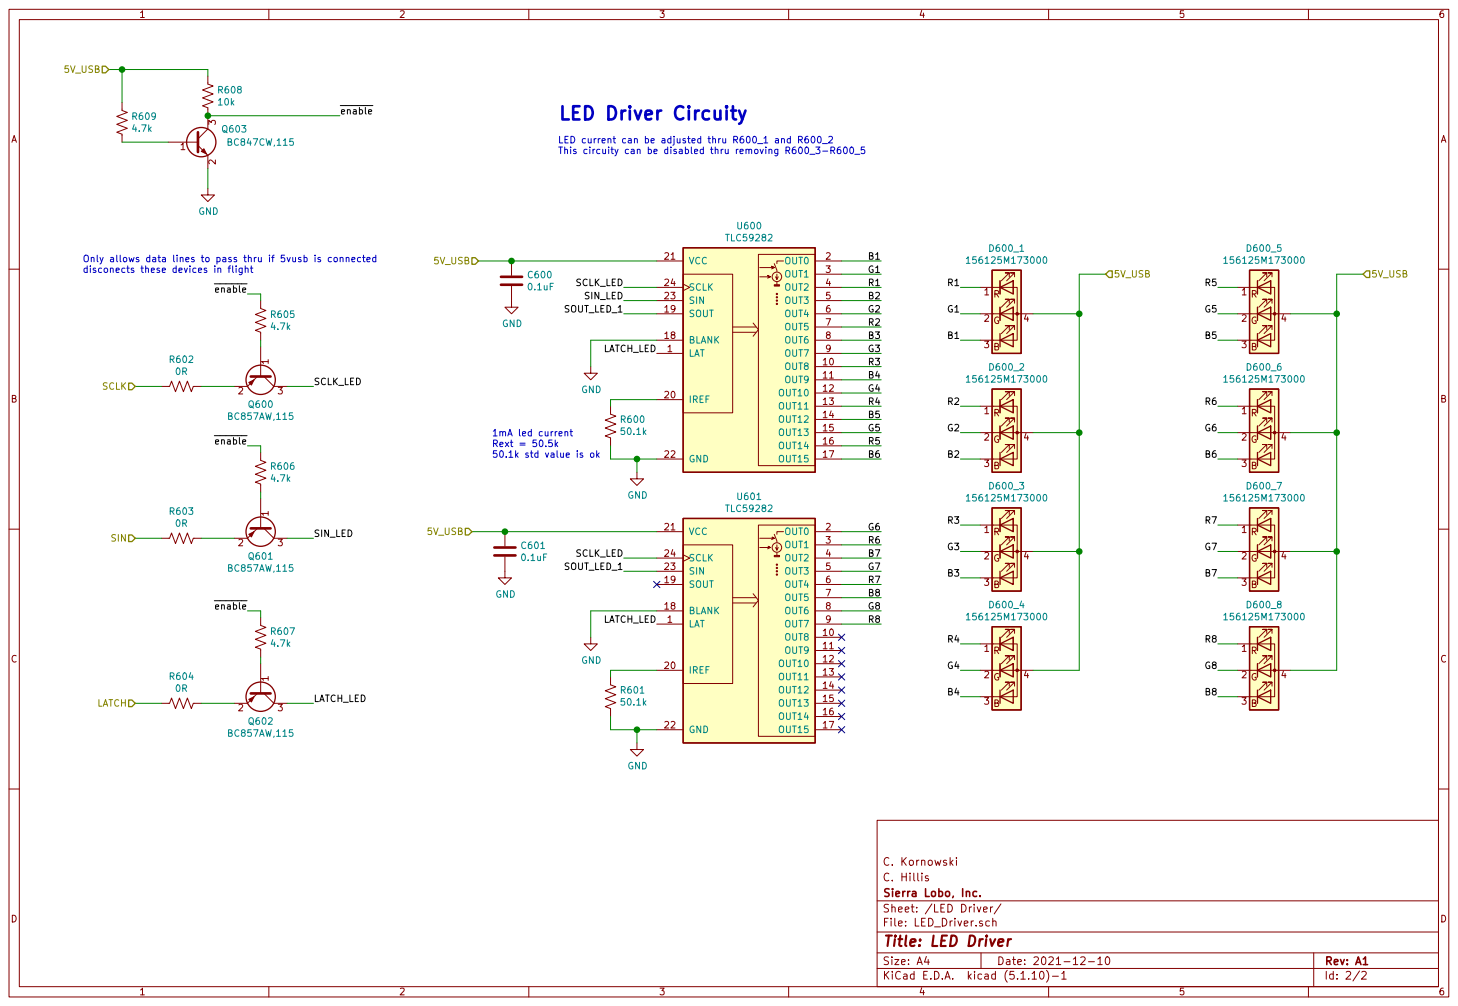
[picture p16: page 2]

This circuity can be disabled thru removing R600_3-R600_5

File: LED_Driver.sch Sheet: /LED Driver/ Sierra Lobo, Inc. C. Hillis C. Kornowski GND

Id: 2/2 Title: LED Driver
