Sierra-Lobo/backplane/revB/pdf/backplane_sch.pdf

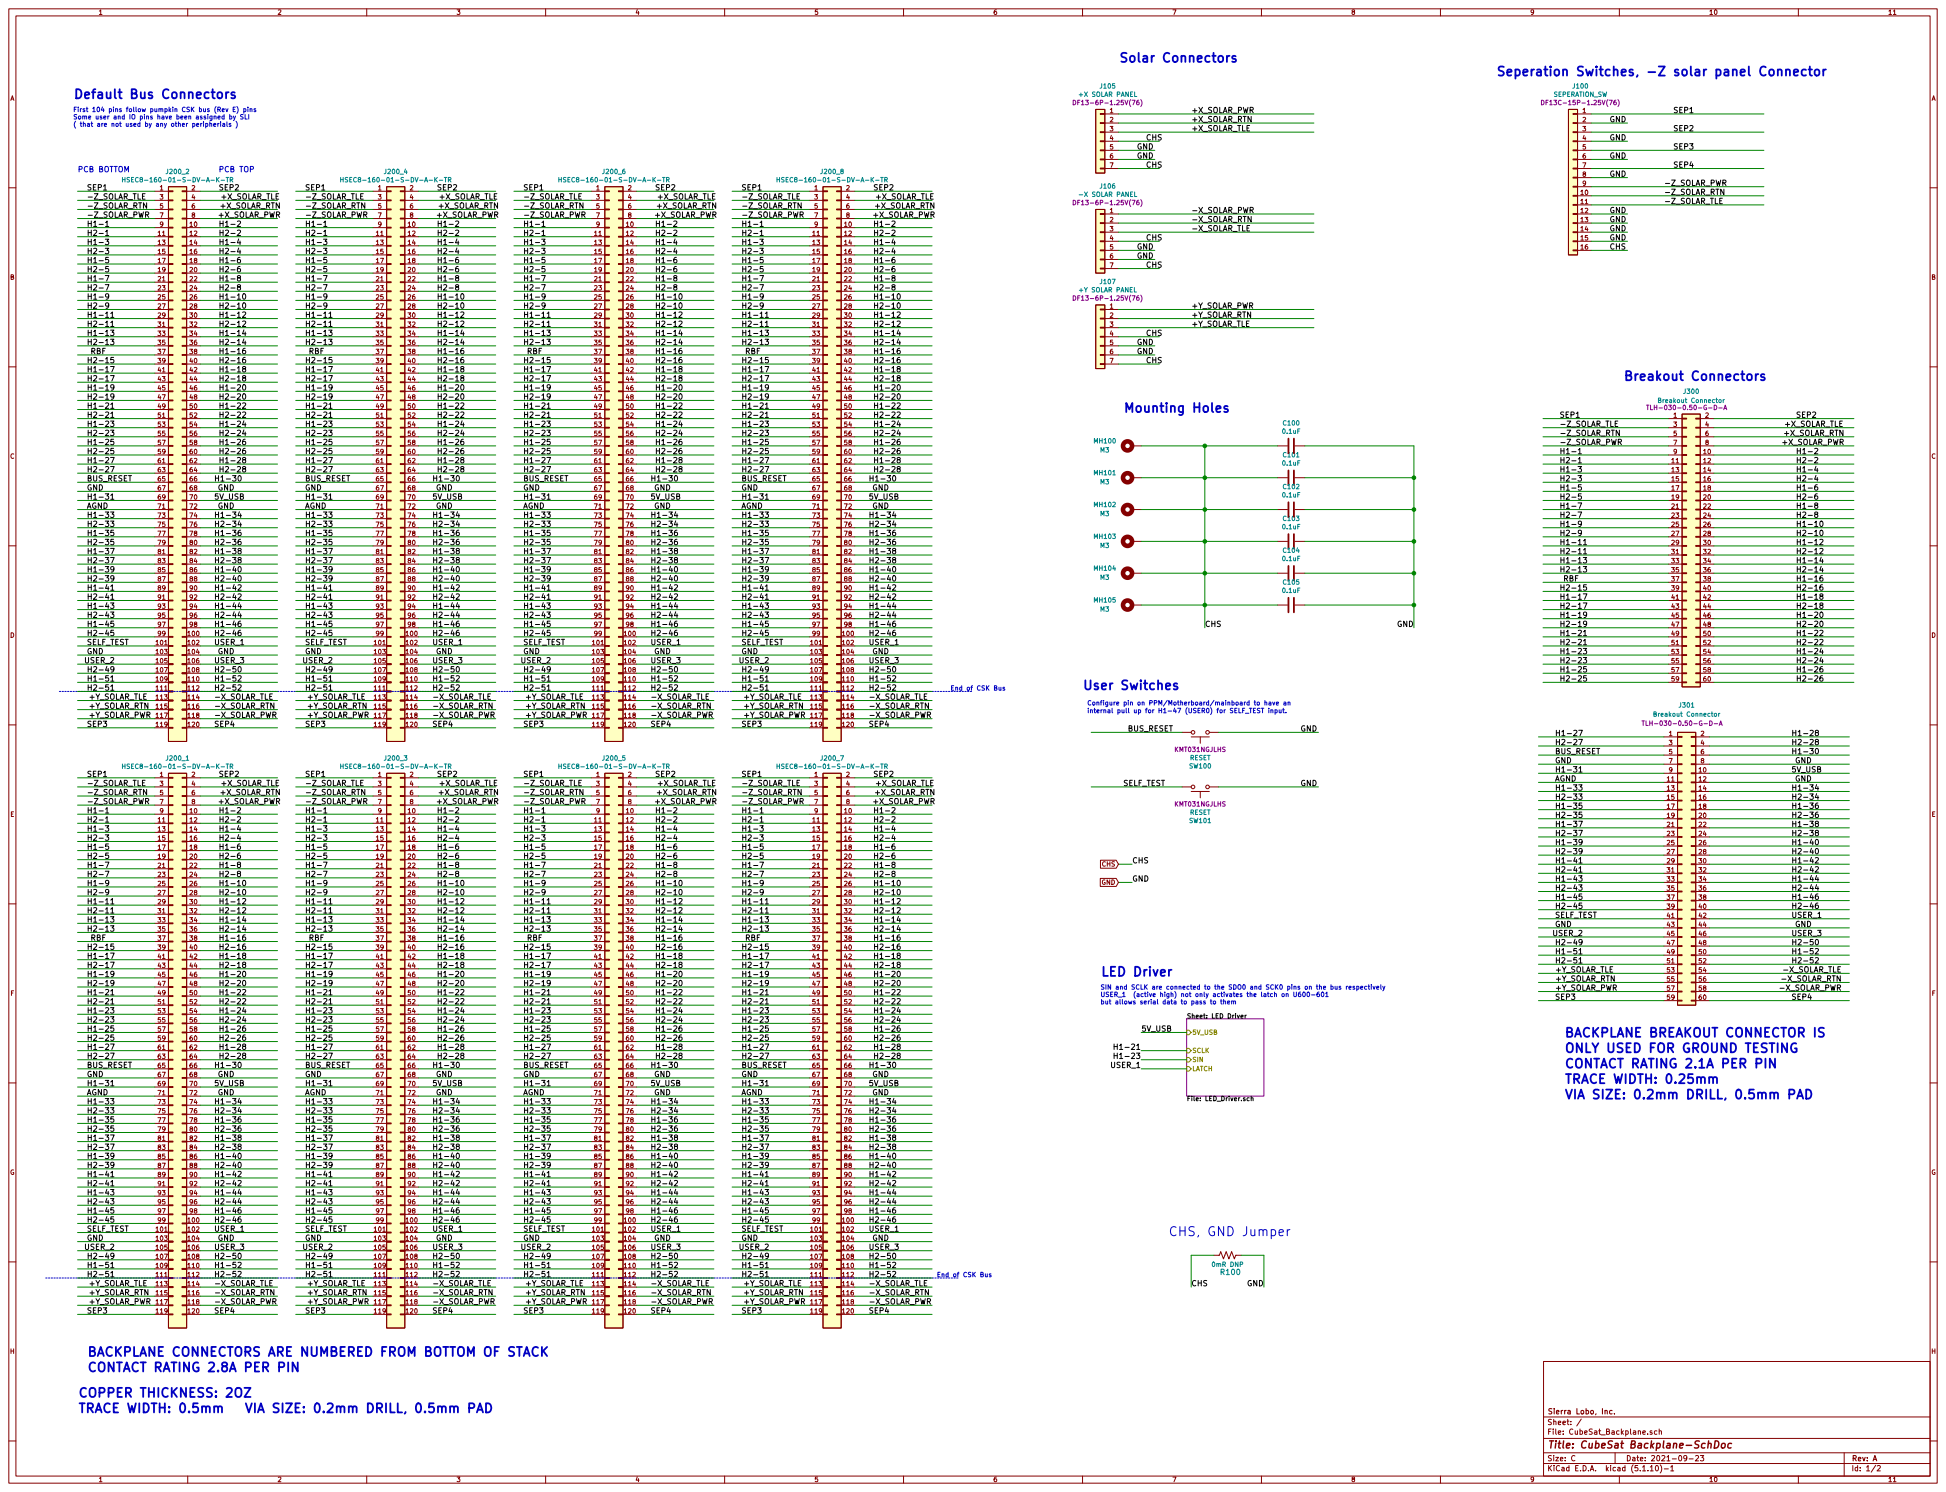
[picture p17: page 1]

Seperation Switches, -Z solar panel Connector

First 104 pins follow pumpkin CSK bus (Rev E) pins
Some user and IO pins have been assigned by SLI
( that are not used by any other peripherials )

Configure pin on PPM/Motherboard/mainboard to have an
internal pull up for H1-47 (USER0) for SELF_TEST input.

USER_1 (active high) not only activates the latch on U600-601
but allows serial data to pass to them

Sheet: LED Driver File: LED_Driver.sch

ONLY USED FOR GROUND TESTING
CONTACT RATING 2.1A PER PIN
TRACE WIDTH: 0.25mm
VIA SIZE: 0.2mm DRILL, 0.5mm PAD

BACKPLANE CONNECTORS ARE NUMBERED FROM BOTTOM OF STACK
CONTACT RATING 2.8A PER PIN
COPPER THICKNESS: 2OZ
TRACE WIDTH: 0.5mm VIA SIZE: 0.2mm DRILL, 0.5mm PAD

File: CubeSat_Backplane.sch Sheet: / Sierra Lobo, Inc.

Id: 1/2 Title: CubeSat Backplane-SchDoc

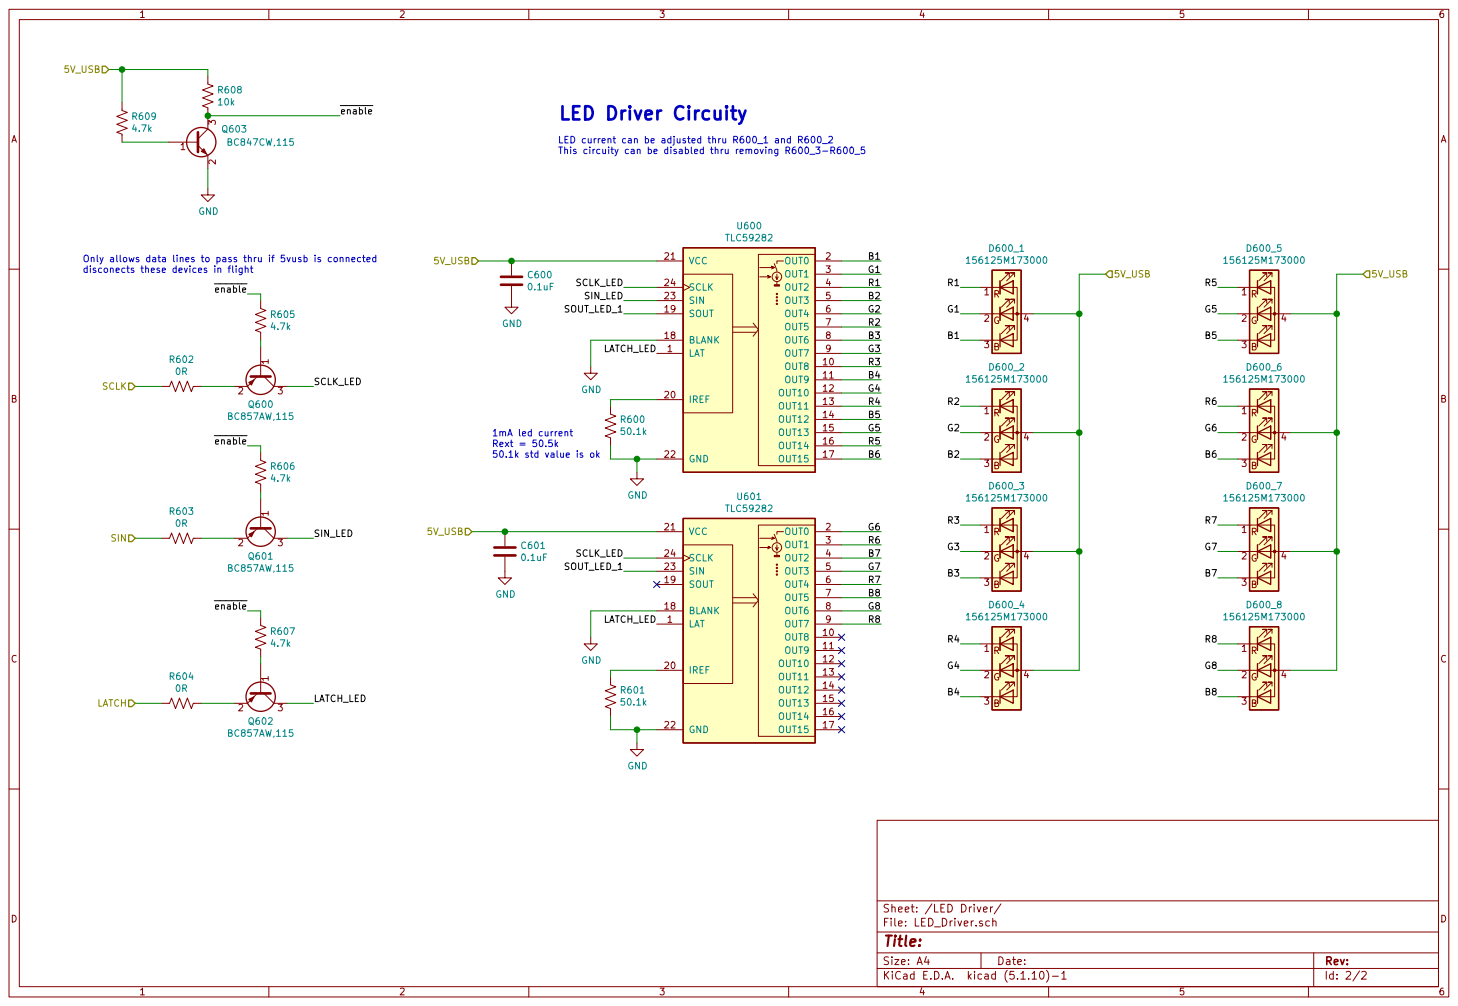
[picture p18: page 2]

This circuity can be disabled thru removing R600_3-R600_5

File: LED_Driver.sch Sheet: /LED Driver/
Id: 2/2 Title:
