Sierra-Lobo/backplane/revB/fabrication-data/PCBway/working file.pdf

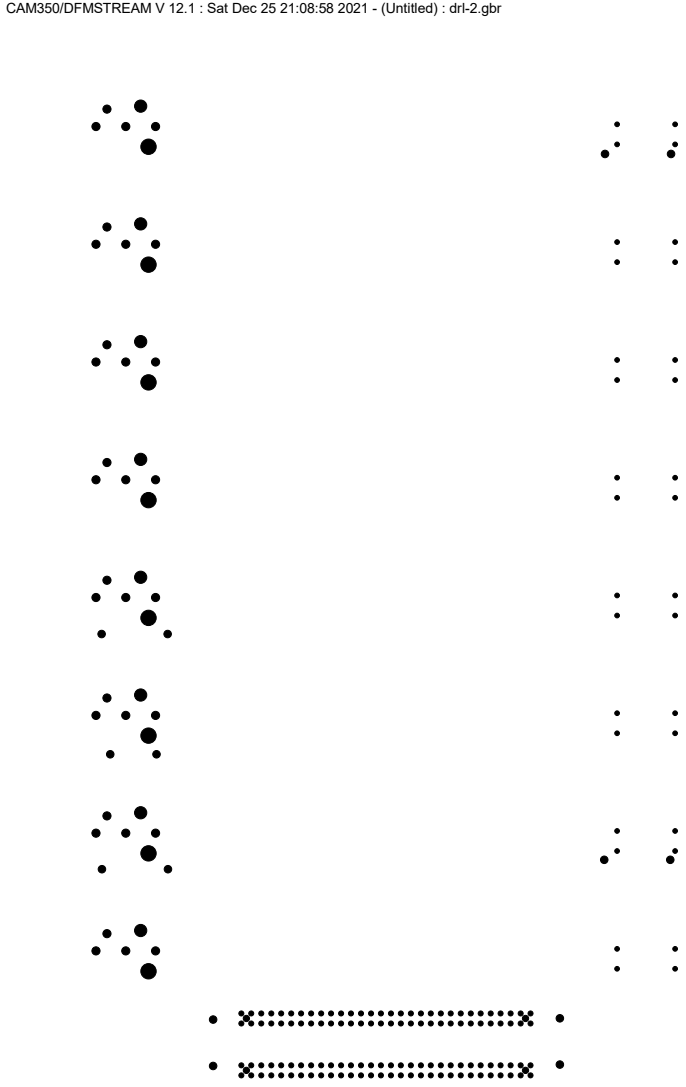
[picture p19: page 1]

CAM350/DFMSTREAM V 12.1 : Sat Dec 25 21:08:58 2021 - (Untitled) : drl-2.gbr

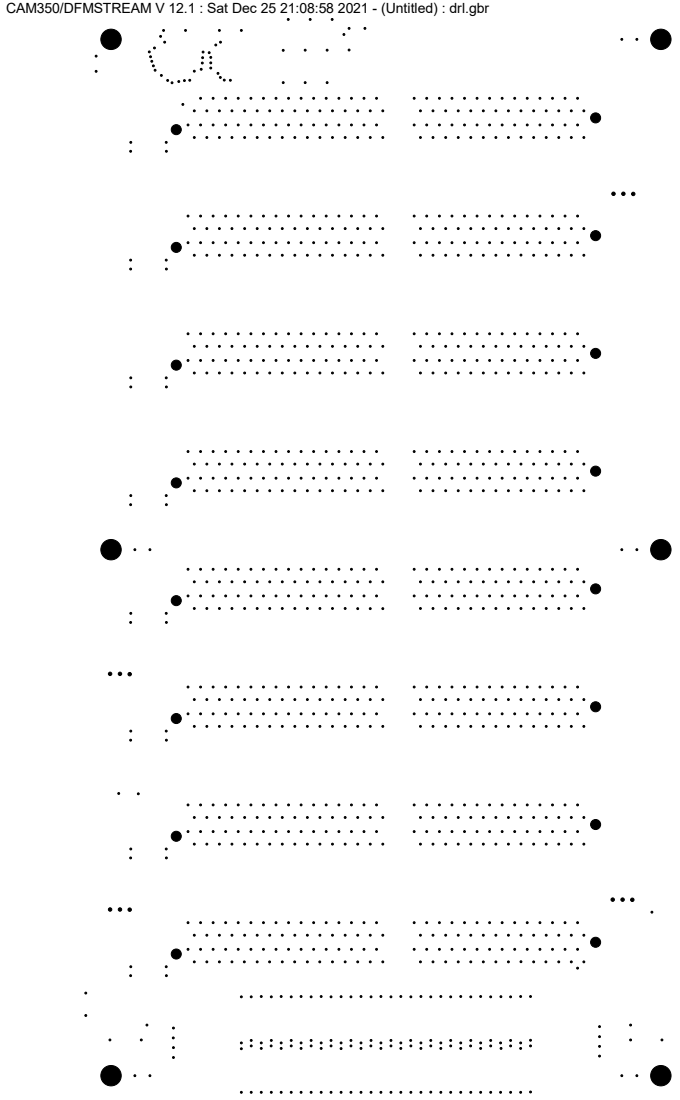
[picture p20: page 2]

CAM350/DFMSTREAM V 12.1 : Sat Dec 25 21:08:58 2021 - (Untitled) : drl.gbr

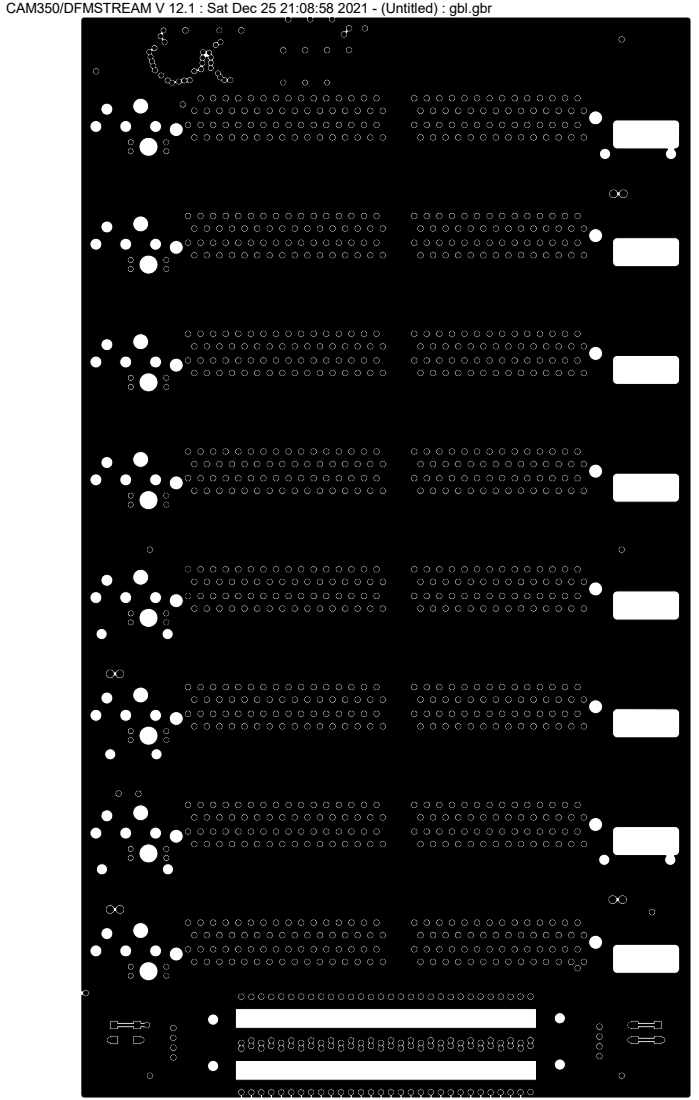
[picture p21: page 3]

CAM350/DFMSTREAM V 12.1 : Sat Dec 25 21:08:58 2021 - (Untitled) : gbl.gbr

CAM350/DFMSTREAM V 12.1 : Sat Dec 25 21:08:58 2021 - (Untitled) : gbo.gbr

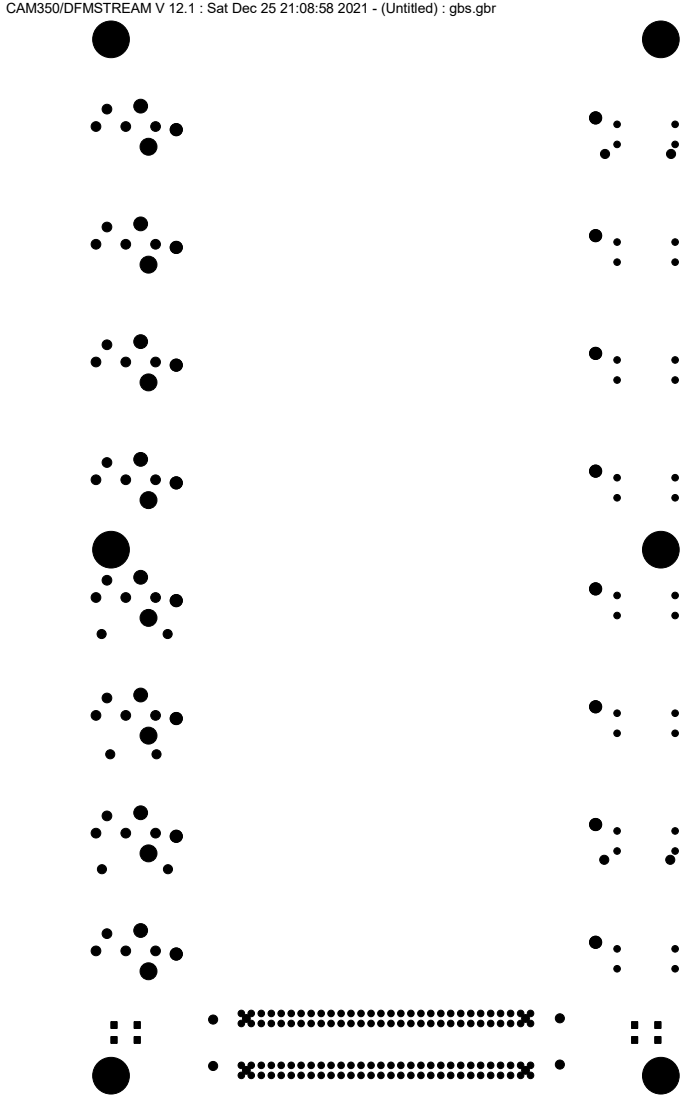
[picture p22: page 5]

CAM350/DFMSTREAM V 12.1 : Sat Dec 25 21:08:58 2021 - (Untitled) : gbs.gbr

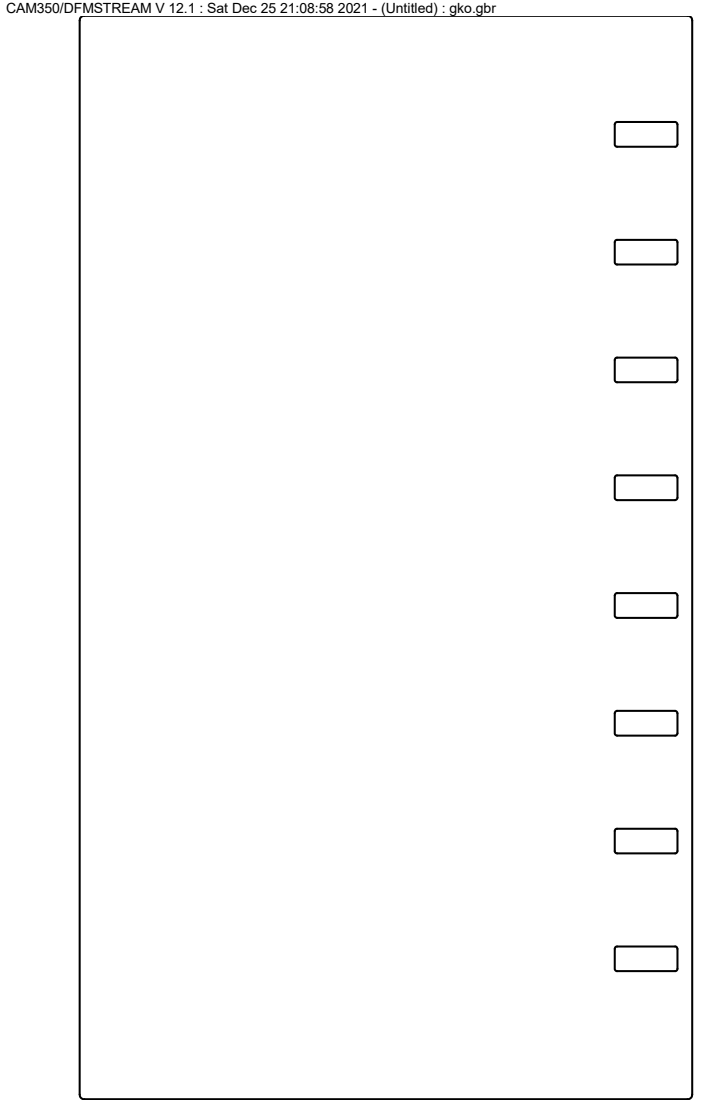
[picture p23: page 6]

CAM350/DFMSTREAM V 12.1 : Sat Dec 25 21:08:58 2021 - (Untitled) : gko.gbr

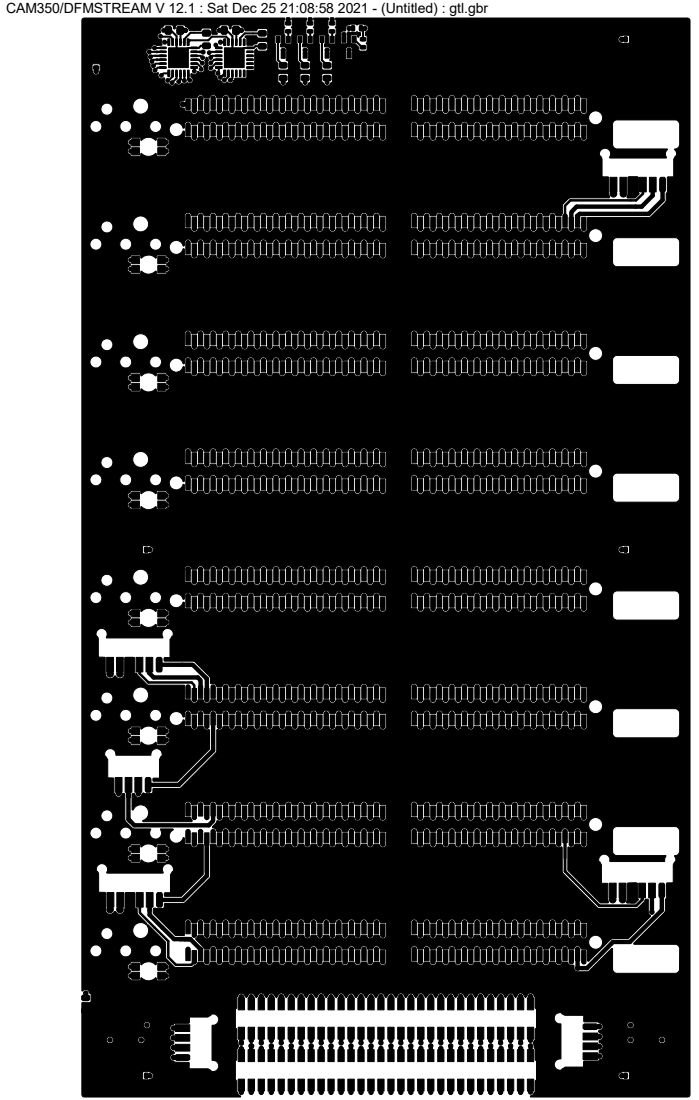
[picture p24: page 7]

CAM350/DFMSTREAM V 12.1 : Sat Dec 25 21:08:58 2021 - (Untitled) : gtl.gbr

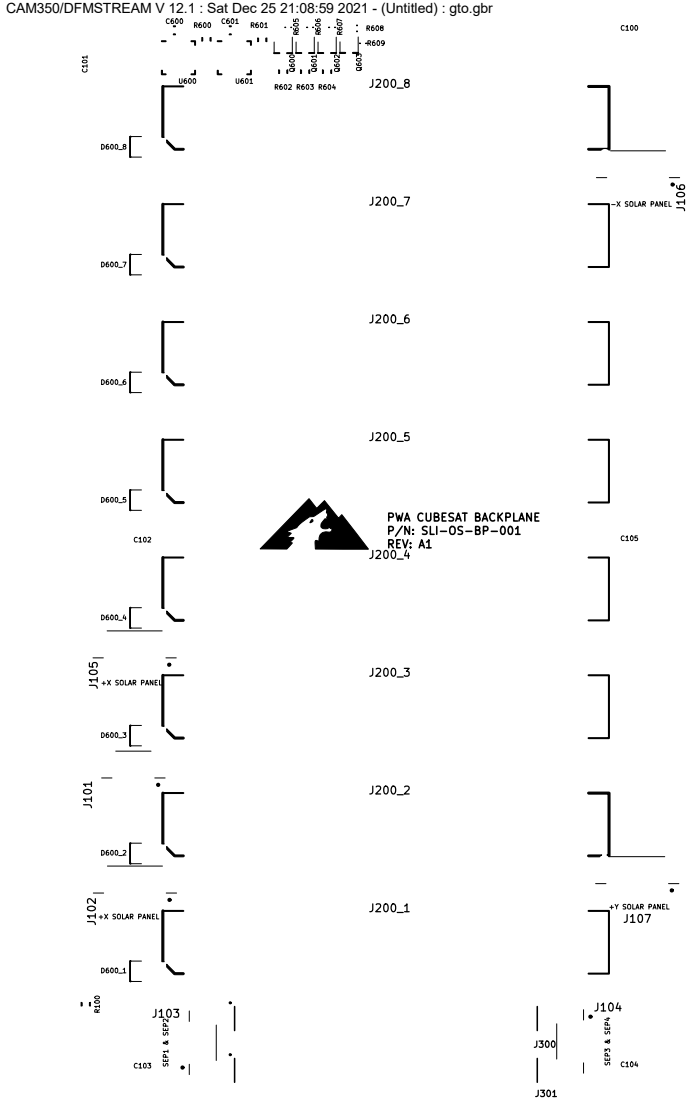
[picture p25: page 8]

CAM350/DFMSTREAM V 12.1 : Sat Dec 25 21:08:59 2021 - (Untitled) : gto.gbr

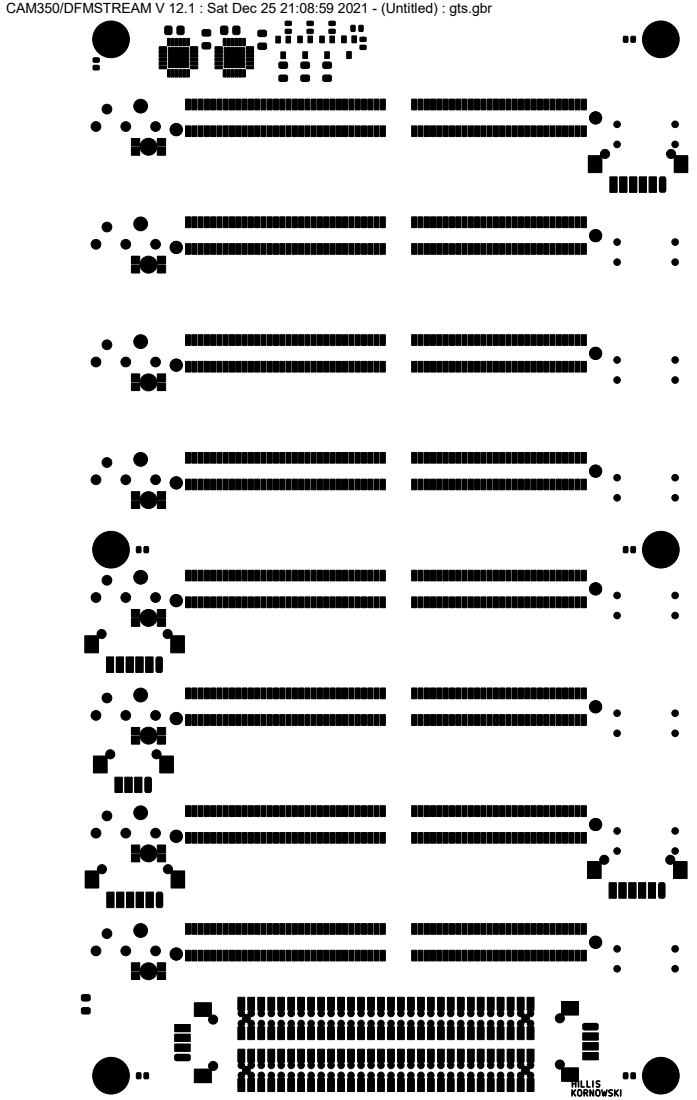
[picture p26: page 9]

CAM350/DFMSTREAM V 12.1 : Sat Dec 25 21:08:59 2021 - (Untitled) : gts.gbr

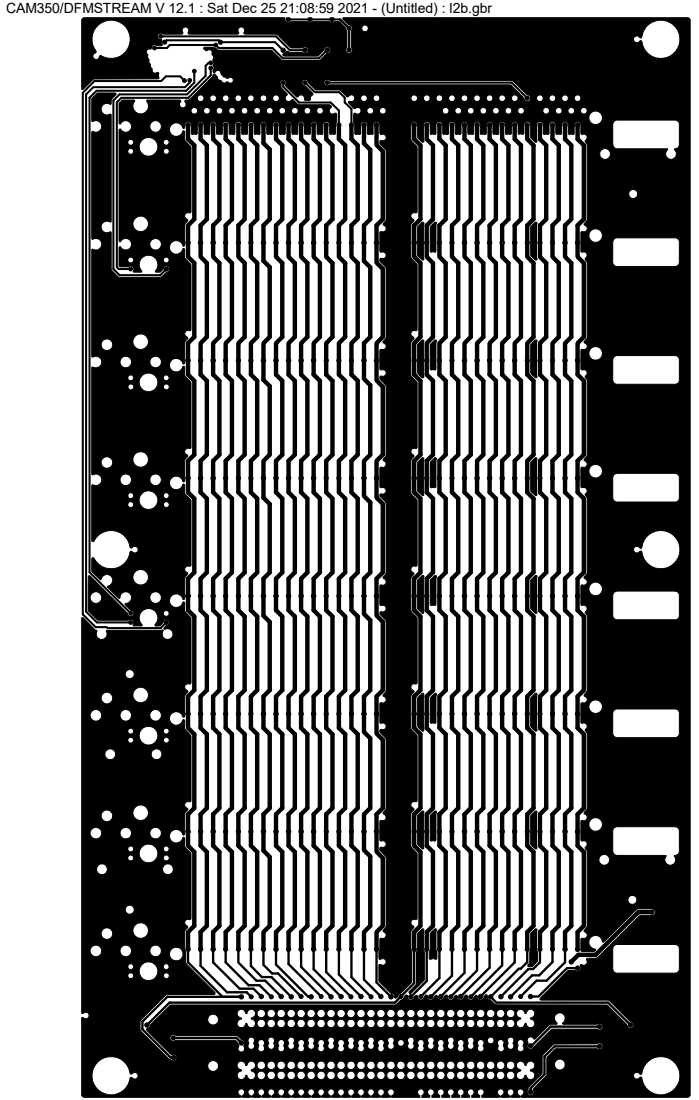
[picture p27: page 10]

CAM350/DFMSTREAM V 12.1 : Sat Dec 25 21:08:59 2021 - (Untitled) : l2b.gbr

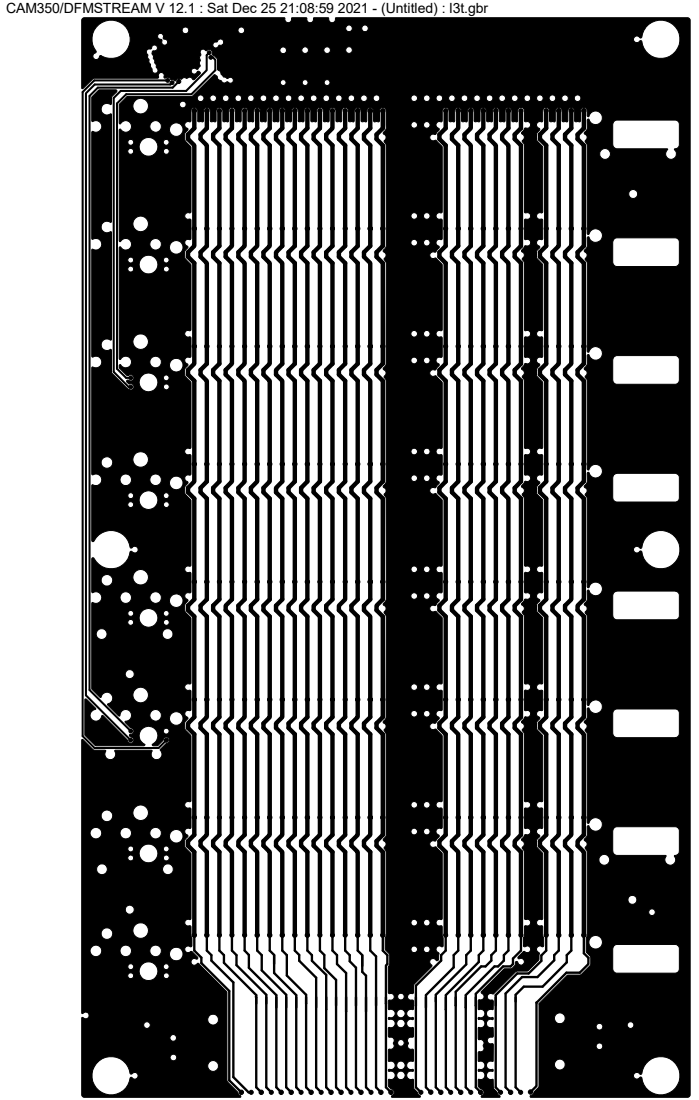
[picture p28: page 11]

CAM350/DFMSTREAM V 12.1 : Sat Dec 25 21:08:59 2021 - (Untitled) : l3t.gbr

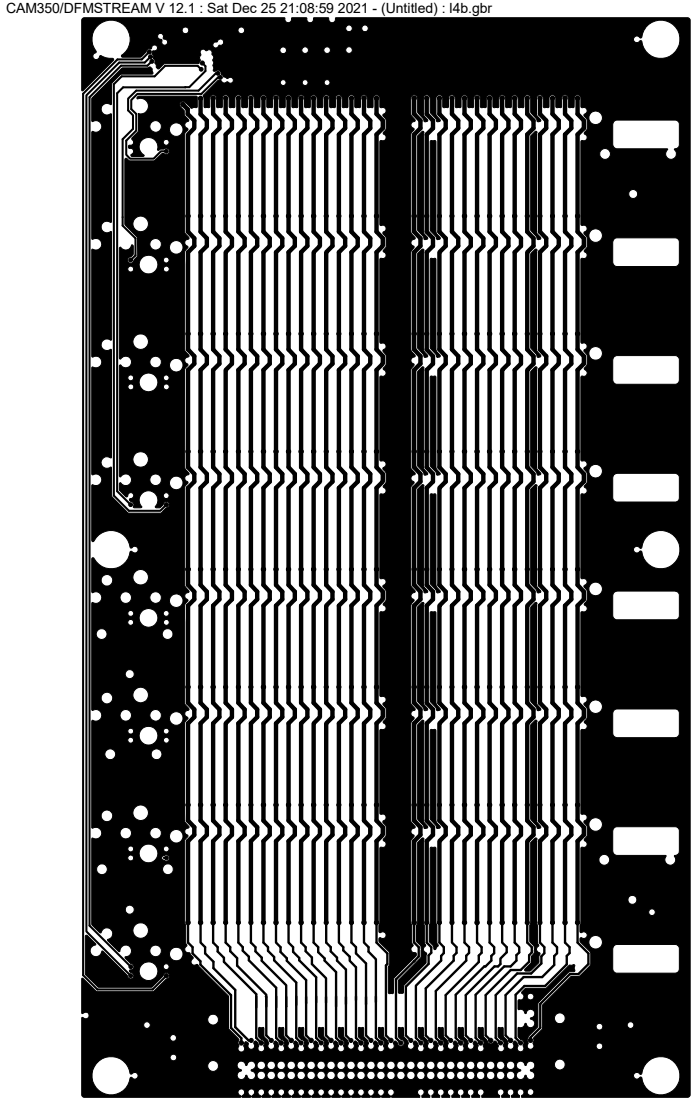
[picture p29: page 12]

CAM350/DFMSTREAM V 12.1 : Sat Dec 25 21:08:59 2021 - (Untitled) : l4b.gbr

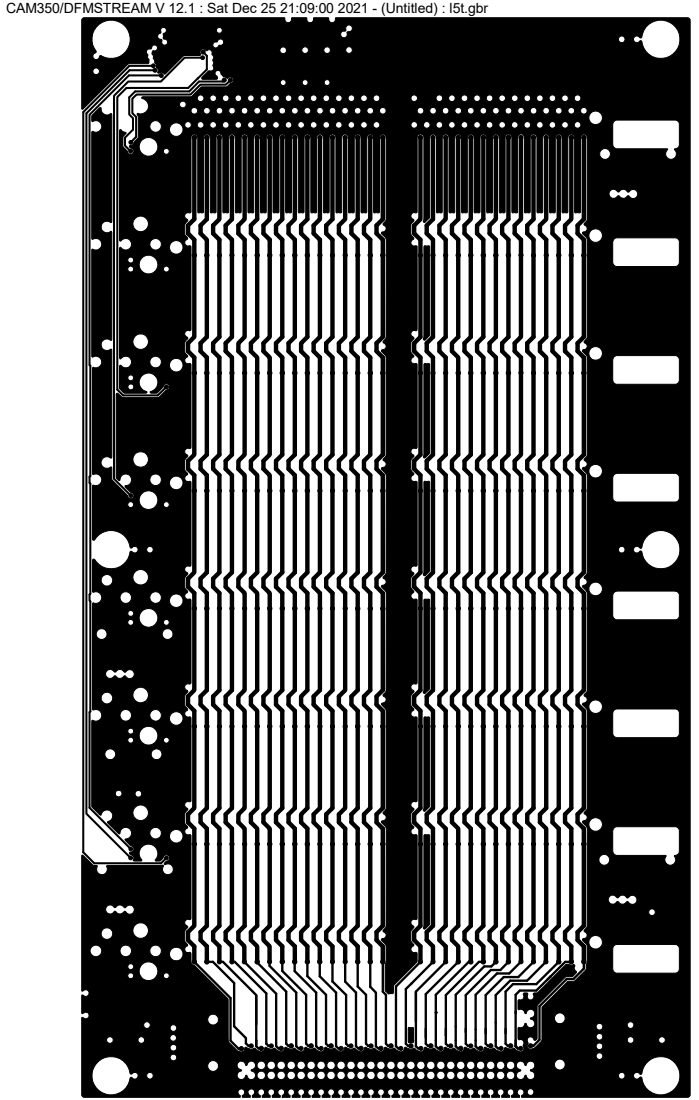
[picture p30: page 13]

CAM350/DFMSTREAM V 12.1 : Sat Dec 25 21:09:00 2021 - (Untitled) : l5t.gbr
