Sierra-Lobo/backplane/backplane-boards/backplane-breakout-big/backplane-breaout-big.kicad_pcb

## KiCad design backplane-boards/backplane-breakout-big/backplane-breaout-big.kicad_pcb (2021-12-20)

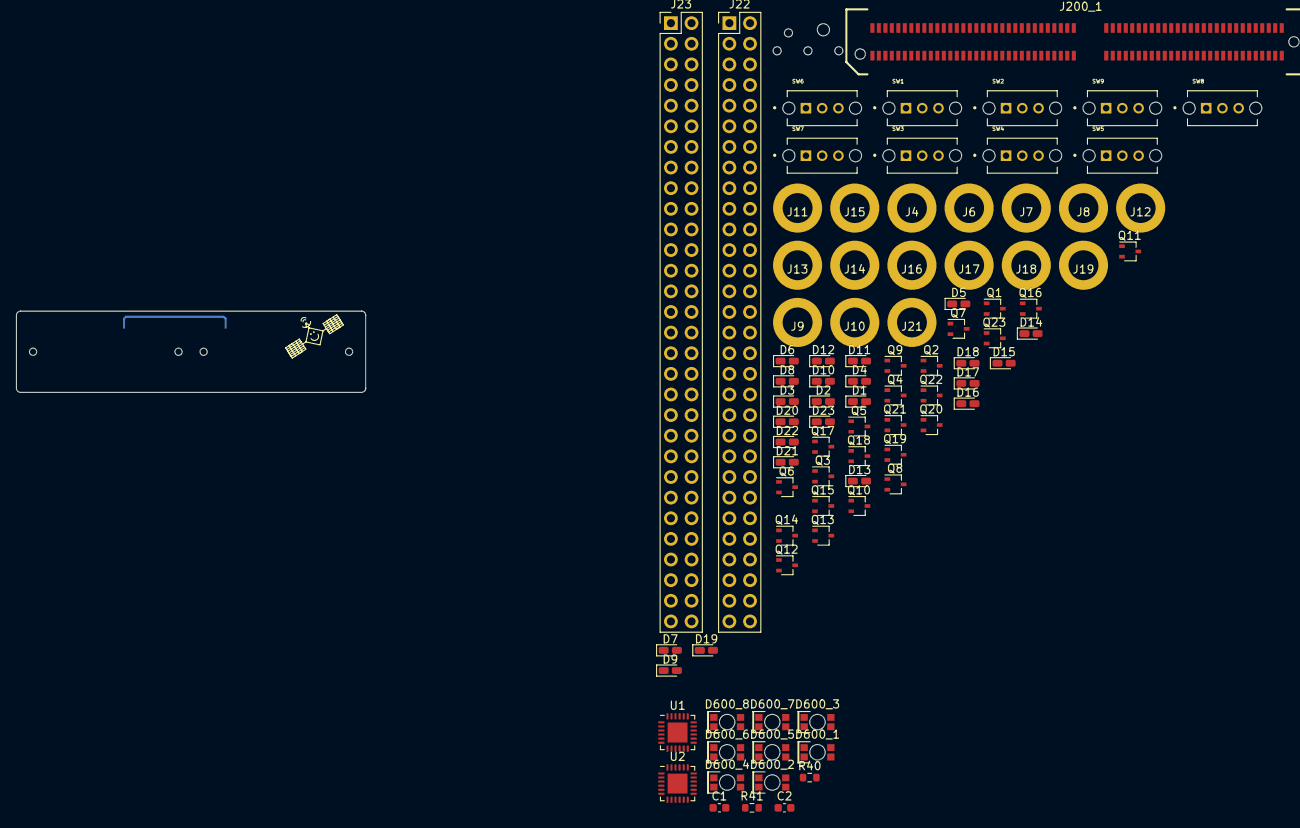
[picture p31: board backplane-breaout-big.kicad_pcb from above]

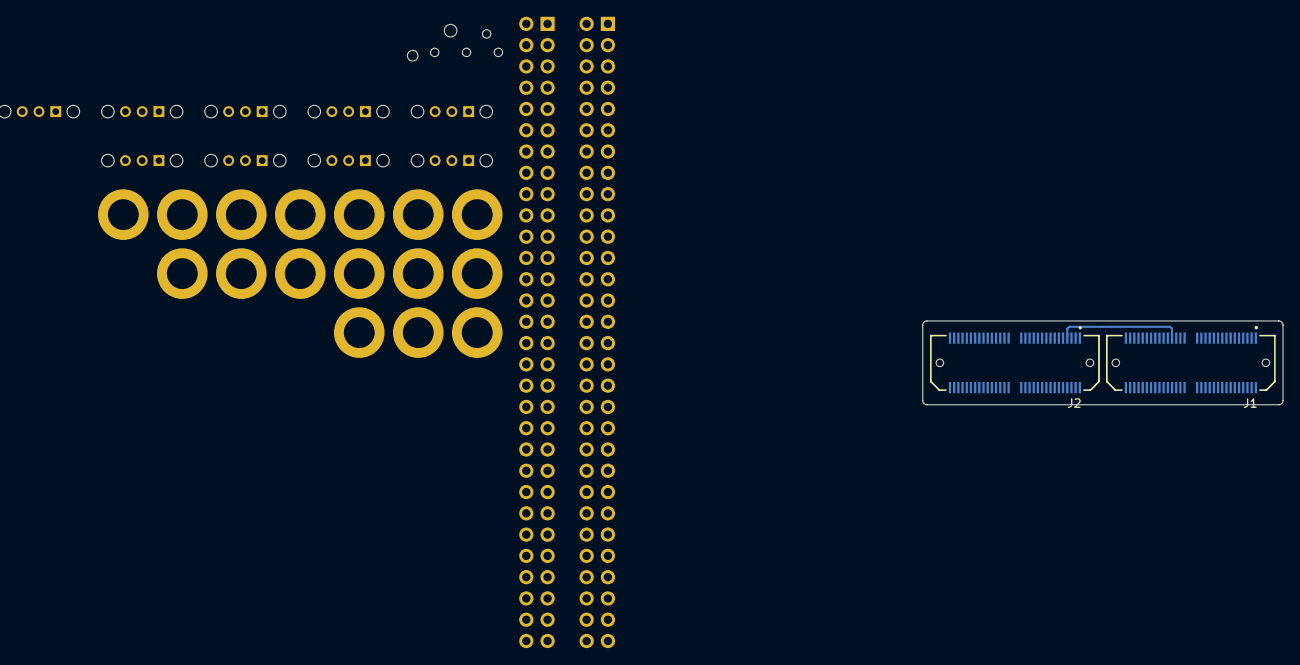
[picture p32: board backplane-breaout-big.kicad_pcb from below]

Board: 2 copper layers, 91 parts (3 on the bottom side), 156 nets.

Parts:
C1, C2: 0.1uF; C_0603_1608Metric
D1, D2, D3, D5, D7, D8, D9, D10: GREEN; LED_0603_1608Metric_Castellated
D4, D6, D11, D12: ORANGE; LED_0603_1608Metric_Castellated
D13, D14, D20, D22: BLUE; LED_0603_1608Metric_Castellated
D15, D16, D17, D18, D19, D21, D23: RED; LED_0603_1608Metric_Castellated
D600_1, D600_2, D600_3, D600_4, D600_5, D600_6, D600_7, D600_8: 156125M173000
J1, J2: Breakout Connector; SAMTEC_LSH-030-01-X-D-A-TR
J4: PACK+; Keystone_476
J6: PACK-; Keystone_476
J7: +X_SOLAR_PWR; Keystone_476
J8: +X_SOLAR_RTN; Keystone_476
J9: -Z_SOLAR_PWR; Keystone_476
J10: -Z_SOLAR_RTN; Keystone_476
J11: +Y_SOLAR_PWR; Keystone_476
J12: +Y_SOLAR_RTN; Keystone_476
J13: -X_SOLAR_PWR; Keystone_476
J14: -X_SOLAR_RTN; Keystone_476
J15: 3.3V_SYS; Keystone_476
J16: +5V_SYS; Keystone_476
J17: VCC_RF; Keystone_476
J18: 5V_DEBUG; Keystone_476
J19: GND; Keystone_476
J21: AGND; Keystone_476
J22, J23: Conn_02x30_Odd_Even; PinHeader_2x30_P2.54mm_Vertical
J200_1: HSEC8-160-01-S-DV-A-K-TR
NT1: Net-Tie_2; NetTie-2_SMD_Pad0.25mm
Q1, Q2, Q3, Q4, Q5, Q6, Q7, Q8, Q9, Q10, Q11, Q12, Q18, Q19, Q22, Q23: DMG1012UW-7; SOT-323_SC-70
Q13, Q14, Q15, Q16, Q17, Q20, Q21: BSS84W-7-F; SOT-323_SC-70
R40, R41: 50.1k; R_0603_1608Metric
SW1: SEP1; SW_OS102011MS2QN1
SW2: SEP2; SW_OS102011MS2QN1
SW3: SEP3; SW_OS102011MS2QN1
SW4: SEP4; SW_OS102011MS2QN1
SW5: RBF; SW_OS102011MS2QN1
SW6: USER_SW_1; SW_OS102011MS2QN1
SW7: USER_SW_2; SW_OS102011MS2QN1
SW8: USER_SW_3; SW_OS102011MS2QN1
SW9: USER_SW_4; SW_OS102011MS2QN1
U1, U2: TLC59282; VQFN-24-1EP_4x4mm_P0.5mm_EP2.45x2.45mm

Connections:
3.3V_SYS: J2.3, J2.4, J15.1, J23.3, J23.4, J200_1.63, J200_1.64
5V_DEBUG: C1.1, C2.1, D600_1.4, D600_2.4, D600_3.4, D600_4.4, D600_5.4, D600_6.4, D600_7.4, D600_8.4, J18.1, Q1.1, Q13.3, Q14.3, Q15.3, Q16.3, Q17.3, Q20.3, Q21.3, U1.21, U2.21
5V_SYS: J1.59, J1.60, J16.1, J22.59, J22.60, J200_1.59, J200_1.60
/5V_USB: J2.10, J23.10, J200_1.70
/+X_SOLAR_PWR: J1.8, J22.8, J200_1.8
/+X_SOLAR_RTN: J1.6, J22.6, J200_1.6
/+X_SOLAR_TLE: J1.4, J22.4, J200_1.4
/+Y_SOLAR_PWR: J2.57, J11.1, J23.57, J200_1.117, Q5.1
/+Y_SOLAR_RTN: J2.55, J12.1, J23.55, J200_1.115
/+Y_SOLAR_TLE: J2.53, J23.53, J200_1.113
/-X_SOLAR_PWR: J2.58, J13.1, J23.58, J200_1.118, Q7.1
/-X_SOLAR_RTN: J2.56, J14.1, J23.56, J200_1.116
/-X_SOLAR_TLE: J2.54, J23.54, J200_1.114
/-Z_SOLAR_PWR: J1.7, J9.1, J22.7, J200_1.7, Q3.1
/-Z_SOLAR_RTN: J1.5, J10.1, J22.5, J200_1.5
/-Z_SOLAR_TLE: J1.3, J22.3, J200_1.3
/AGND: J2.11, J21.1, J23.11, J200_1.71
/BUS_RESET: J2.5, J23.5, J200_1.65, Q20.1
/Backplane LEDs/B1: D600_1.3, U1.2
/Backplane LEDs/B2: D600_3.3, U1.5
/Backplane LEDs/B3: D600_5.3, U1.8
/Backplane LEDs/B4: D600_7.3, U1.11
/Backplane LEDs/B5: D600_2.3, U1.14
/Backplane LEDs/B6: D600_4.3, U1.17
/Backplane LEDs/B7: D600_6.3, U2.4
/Backplane LEDs/B8: D600_8.3, U2.7
/Backplane LEDs/G1: D600_1.2, U1.3
/Backplane LEDs/G2: D600_3.2, U1.6
/Backplane LEDs/G3: D600_5.2, U1.9
/Backplane LEDs/G4: D600_7.2, U1.12
/Backplane LEDs/G5: D600_2.2, U1.15
/Backplane LEDs/G6: D600_4.2, U2.2
/Backplane LEDs/G7: D600_6.2, U2.5
/Backplane LEDs/G8: D600_8.2, U2.8
/Backplane LEDs/R1: D600_1.1, U1.4
/Backplane LEDs/R2: D600_3.1, U1.7
/Backplane LEDs/R3: D600_5.1, U1.10
/Backplane LEDs/R4: D600_7.1, U1.13
/Backplane LEDs/R5: D600_2.1, U1.16
/Backplane LEDs/R6: D600_4.1, U2.3
/Backplane LEDs/R7: D600_6.1, U2.6
/Backplane LEDs/R8: D600_8.1, U2.9
/Backplane LEDs/SOUT: U1.19, U2.23
/H1-1: J1.9, J22.9, J200_1.9
/H1-2: J1.10, J22.10, J200_1.10
/H1-3: J1.13, J22.13, J200_1.13
/H1-4: J1.14, J22.14, J200_1.14
/H1-5: J1.17, J22.17, J200_1.17
/H1-6: J1.18, J22.18, J200_1.18
/H1-7: J1.21, J22.21, J200_1.21
/H1-8: J1.22, J22.22, J200_1.22
/H1-9: J1.25, J22.25, J200_1.25
/H1-10: J1.26, J22.26, J200_1.26
/H1-11: J1.29, J22.29, J200_1.29
/H1-12: J1.30, J22.30, J200_1.30
/H1-13: J1.33, J22.33, J200_1.33
/H1-14: J1.34, J22.34, J200_1.34
/H1-16: J1.38, J22.38, J200_1.38
/H1-17: J1.41, J22.41, J200_1.41
/H1-18: J1.42, J22.42, J200_1.42
/H1-19: J1.45, J22.45, J200_1.45
/H1-20: J1.46, J22.46, J200_1.46
/H1-21: J1.49, J22.49, J200_1.49, U1.24, U2.24
/H1-22: J1.50, J22.50, J200_1.50
/H1-23: J1.53, J22.53, J200_1.53, U1.23
/H1-24: J1.54, J22.54, J200_1.54
/H1-25: J1.57, J22.57, J200_1.57
/H1-26: J1.58, J22.58, J200_1.58
/H1-27: J2.1, J23.1, J200_1.61
/H1-28: J2.2, J23.2, J200_1.62
/H1-30: J2.6, J23.6, J200_1.66
/H1-31: J2.9, J23.9, J200_1.69
/H1-34: J2.14, J23.14, J200_1.74
/H1-35: J2.17, J23.17, J200_1.77
/H1-36: J2.18, J23.18, J200_1.78
/H1-37: J2.21, J23.21, J200_1.81
/H1-38: J2.22, J23.22, J200_1.82
/H1-39: J2.25, J23.25, J200_1.85
/H1-40: J2.26, J23.26, J200_1.86
/H1-41: J2.29, J23.29, J200_1.89
/H1-42: J2.30, J23.30, J200_1.90
/H1-43: J2.33, J23.33, J200_1.93
/H1-44: J2.34, J23.34, J200_1.94
/H1-45: J2.37, J23.37, J200_1.97
/H1-46: J2.38, J23.38, J200_1.98
/H1-51: J2.49, J23.49, J200_1.109
/H1-52: J2.50, J23.50, J200_1.110
/H2-1: J1.11, J22.11, J200_1.11
/H2-2: J1.12, J22.12, J200_1.12
/H2-3: J1.15, J22.15, J200_1.15
/H2-4: J1.16, J22.16, J200_1.16
/H2-5: J1.19, J22.19, J200_1.19
/H2-6: J1.20, J22.20, J200_1.20
/H2-7: J1.23, J22.23, J200_1.23
/H2-8: J1.24, J22.24, J200_1.24
/H2-9: J1.27, J22.27, J200_1.27
/H2-10: J1.28, J22.28, J200_1.28
/H2-11: J1.31, J22.31, J200_1.31
/H2-12: J1.32, J22.32, J200_1.32
/H2-13: J1.35, J22.35, J200_1.35
/H2-14: J1.36, J22.36, J200_1.36
/H2-15: J1.39, J22.39, J200_1.39
/H2-16: J1.40, J22.40, J200_1.40
/H2-17: J1.43, J22.43, J200_1.43
/H2-18: J1.44, J22.44, J200_1.44
/H2-19: J1.47, J22.47, J200_1.47
/H2-20: J1.48, J22.48, J200_1.48
/H2-21: J1.51, J22.51, J200_1.51
/H2-22: J1.52, J22.52, J200_1.52
/H2-23: J1.55, J22.55, J200_1.55
/H2-24: J1.56, J22.56, J200_1.56
/H2-33: J2.15, J23.15, J200_1.75
/H2-34: J2.16, J23.16, J200_1.76
/H2-35: J2.19, J23.19, J200_1.79
/H2-36: J2.20, J23.20, J200_1.80
/H2-37: J2.23, J23.23, J200_1.83
/H2-38: J2.24, J23.24, J200_1.84
/H2-39: J2.27, J23.27, J200_1.87
/H2-40: J2.28, J23.28, J200_1.88
/H2-41: J2.31, J23.31, J200_1.91
/H2-42: J2.32, J23.32, J200_1.92
/H2-43: J2.35, J23.35, J200_1.95
/H2-44: J2.36, J23.36, J200_1.96
/H2-51: J2.51, J23.51, J200_1.111
/H2-52: J2.52, J23.52, J200_1.112
/RBF: J1.37, J22.37, J200_1.37, NT1.1, Q17.1
/SELF_TEST: J2.41, J23.41, J200_1.101, Q21.1
/SEP1: J1.1, J22.1, J200_1.1, Q13.1
/SEP2: J1.2, J22.2, J200_1.2, Q14.1
/SEP3: J2.59, J23.59, J200_1.119, Q15.1
/SEP4: J2.60, J23.60, J200_1.120, Q16.1
/USER_1: J2.42, J23.42, J200_1.102, U1.1
/USER_2: J2.45, J23.45, J200_1.105
/USER_3: J2.46, J23.46, J200_1.106
EP: C1.2, C2.2, D15.1, D16.1, D17.1, D18.1, D19.1, D21.1, D23.1, J2.7, J2.8, J2.12, J2.43, J2.44, J19.1, J23.7, J23.8, J23.12, J23.43, J23.44, J200_1.67, J200_1.68, J200_1.72, J200_1.103, J200_1.104, Q1.2, Q2.2, Q3.2, Q4.2, Q5.2, Q6.2, Q7.2, Q8.2, Q9.2, Q10.2, Q11.2, Q12.2, Q18.2, Q19.2, Q22.2, Q23.2, R40.1, R41.1, SW1.3, SW2.3, SW3.3, SW4.3, SW5.3, U1.18, U1.22, U1.25, U2.18, U2.22, U2.25
unnamed: D1.1, Q1.3
unnamed: D2.1, Q2.3
unnamed: D3.1, Q3.3
unnamed: D4.1, Q4.3
unnamed: D5.1, Q5.3
unnamed: D6.1, Q6.3
unnamed: D7.1, Q7.3
unnamed: D8.1, Q8.3
unnamed: D9.1, Q9.3
unnamed: D10.1, Q10.3
unnamed: D11.1, Q11.3
unnamed: D12.1, Q12.3
unnamed: D13.1, Q18.3
unnamed: D14.1, Q19.3
unnamed: D20.1, Q22.3
unnamed: D22.1, Q23.3
unnamed: R40.2, U1.20
unnamed: R41.2, U2.20
VBATT: J2.39, J2.40, J4.1, J23.39, J23.40, J200_1.99, J200_1.100, Q9.1
VBATT_RET: J2.47, J2.48, J6.1, J23.47, J23.48, J200_1.107, J200_1.108
V_RF: J2.13, J17.1, J23.13, J200_1.73, Q8.1
