Sierra-Lobo/backplane/revC1/LED_Driver.kicad_sch

## KiCad design revC1/LED_Driver.kicad_sch (2023-06-22)

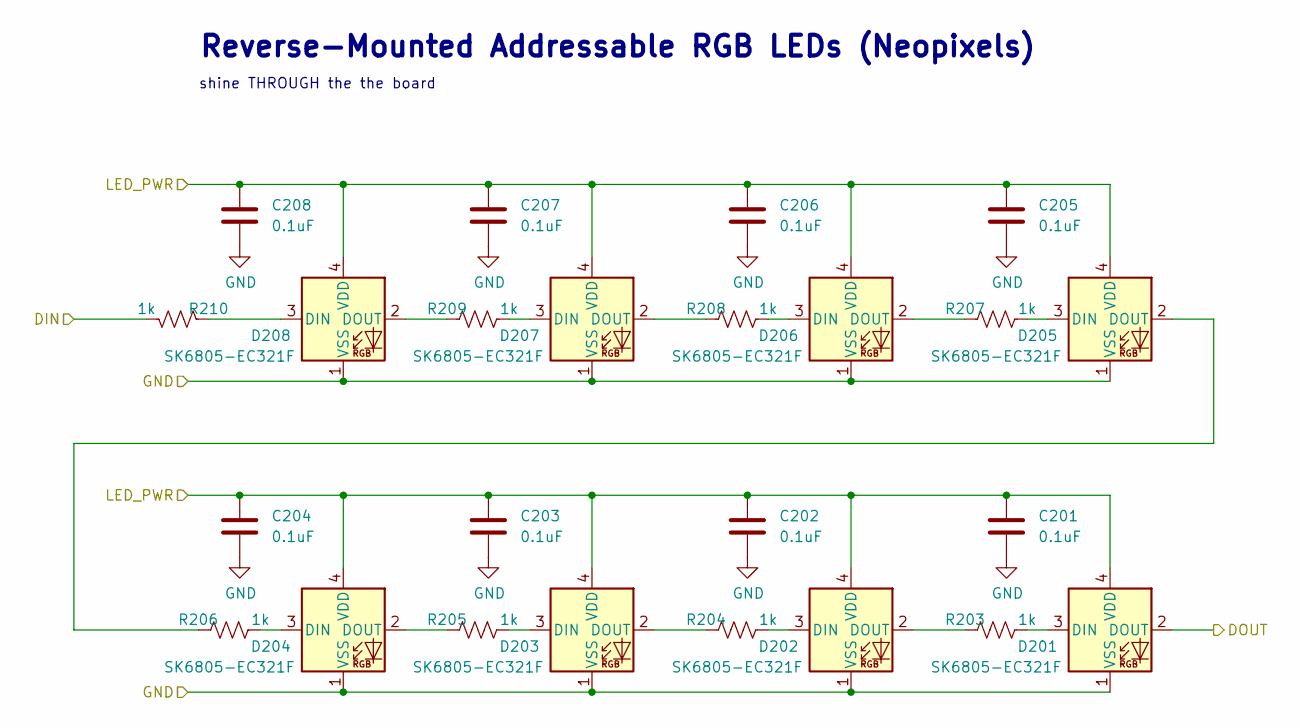
[picture p33: schematic LED_Driver.kicad_sch]

Parts:
C201, C202, C203, C204, C205, C206, C207, C208: 0.1uF; C_0402_1005Metric
D201, D202, D203, D204, D205, D206, D207, D208: SK6805-EC321F; SK68xx-EC120x_ReverseMount; Manufacturer Part Numbe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 SK6812-EC321R
R203, R204, R205, R206, R207, R208, R209, R210: 1k; R_0402_1005Metric

Connections:
DIN: R210.2
DOUT: D201.2 (DOUT)
GND: C201.2, C202.2, C203.2, C204.2, C205.2, C206.2, C207.2, C208.2, D201.1 (VSS), D202.1 (VSS), D203.1 (VSS), D204.1 (VSS), D205.1 (VSS), D206.1 (VSS), D207.1 (VSS), D208.1 (VSS)
LED_PWR: C201.1, C202.1, C203.1, C204.1, C205.1, C206.1, C207.1, C208.1, D201.4 (VDD), D202.4 (VDD), D203.4 (VDD), D204.4 (VDD), D205.4 (VDD), D206.4 (VDD), D207.4 (VDD), D208.4 (VDD)
unnamed: D201.3 (DIN), R203.2
unnamed: D202.2 (DOUT), R203.1
unnamed: D202.3 (DIN), R204.2
unnamed: D203.2 (DOUT), R204.1
unnamed: D203.3 (DIN), R205.2
unnamed: D204.2 (DOUT), R205.1
unnamed: D204.3 (DIN), R206.2
unnamed: D205.2 (DOUT), R206.1
unnamed: D205.3 (DIN), R207.2
unnamed: D206.2 (DOUT), R207.1
unnamed: D206.3 (DIN), R208.2
unnamed: D207.2 (DOUT), R208.1
unnamed: D207.3 (DIN), R209.2
unnamed: D208.2 (DOUT), R209.1
unnamed: D208.3 (DIN), R210.1

Notes on the sheet:
shine THROUGH the the board
Reverse-Mounted Addressable RGB LEDs (Neopixels)
