Sierra-Lobo/backplane/revC/LED_Driver.kicad_sch

## KiCad design revC/LED_Driver.kicad_sch (2022-05-10)

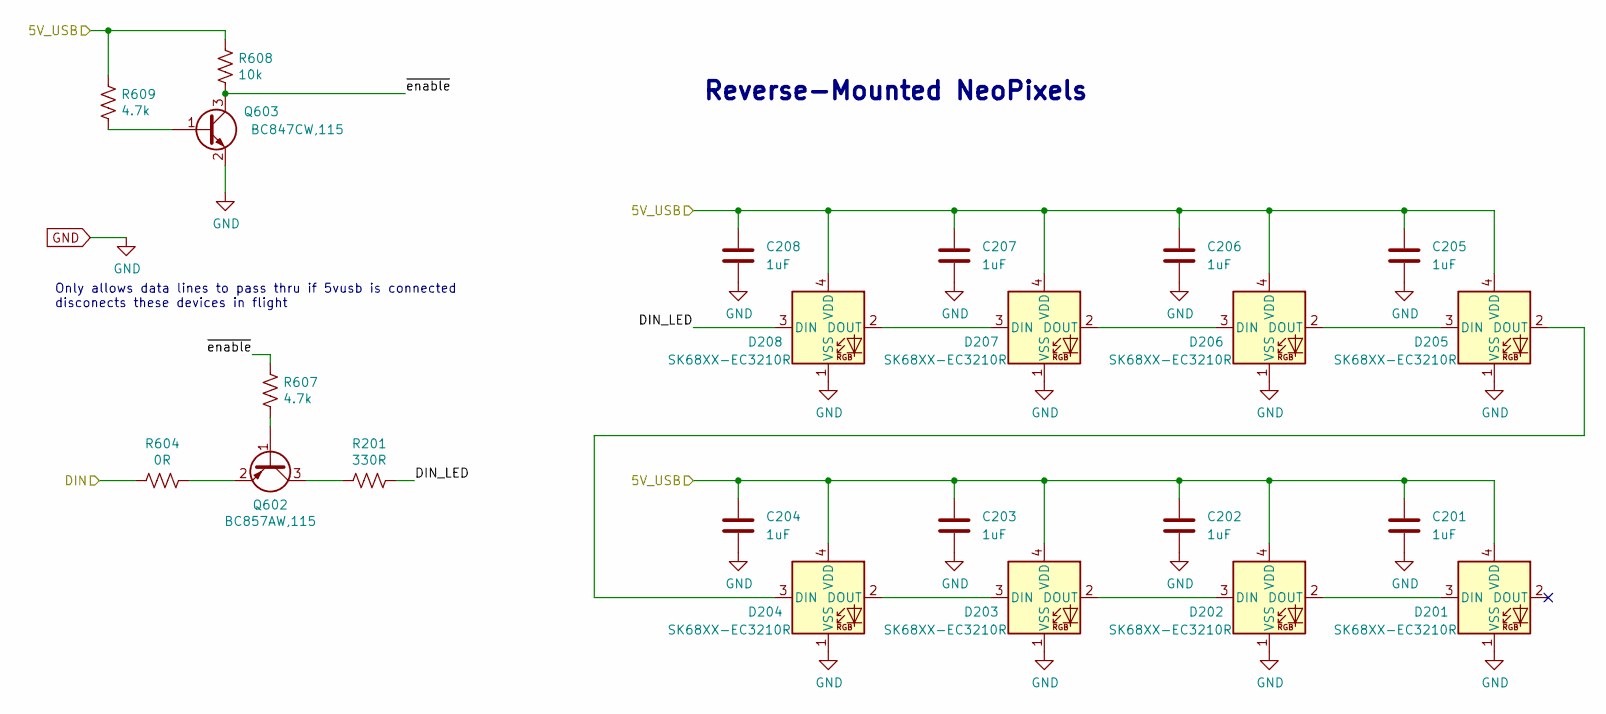
[picture p36: schematic LED_Driver.kicad_sch]

Parts:
C201, C202, C203, C204, C205, C206, C207, C208: 1uF; C_0603_1608Metric
D201, D202, D203, D204, D205, D206, D207, D208: SK68XX-EC3210R; SK6812-EC3210F
Q602: BC857AW,115; SOT-323_SC-70
Q603: BC847CW,115; SOT-323_SC-70
R201: 330R; R_0402_1005Metric
R604: 0R; R_0402_1005Metric
R607, R609: 4.7k; R_0402_1005Metric
R608: 10k; R_0402_1005Metric

Connections:
5V_USB: C201.1, C202.1, C203.1, C204.1, C205.1, C206.1, C207.1, C208.1, D201.4 (VDD), D202.4 (VDD), D203.4 (VDD), D204.4 (VDD), D205.4 (VDD), D206.4 (VDD), D207.4 (VDD), D208.4 (VDD), R608.1, R609.1
DIN: R604.2
DIN_LED: D208.3 (DIN), R201.1
GND: C201.2, C202.2, C203.2, C204.2, C205.2, C206.2, C207.2, C208.2, D201.1 (VSS), D202.1 (VSS), D203.1 (VSS), D204.1 (VSS), D205.1 (VSS), D206.1 (VSS), D207.1 (VSS), D208.1 (VSS), Q603.2 (E)
unnamed: D201.3 (DIN), D202.2 (DOUT)
unnamed: D202.3 (DIN), D203.2 (DOUT)
unnamed: D203.3 (DIN), D204.2 (DOUT)
unnamed: D204.3 (DIN), D205.2 (DOUT)
unnamed: D205.3 (DIN), D206.2 (DOUT)
unnamed: D206.3 (DIN), D207.2 (DOUT)
unnamed: D207.3 (DIN), D208.2 (DOUT)
unnamed: Q602.1 (B), R607.2
unnamed: Q602.2 (E), R604.1
unnamed: Q602.3 (C), R201.2
unnamed: Q603.1 (B), R609.2
~enable: Q603.3 (C), R607.1, R608.2

Notes on the sheet:
Reverse-Mounted NeoPixels
Only allows data lines to pass thru if 5vusb is connected disconects these devices in flight
