Sierra-Lobo/backplane/revC/backplane.kicad_sch

## KiCad design revC/backplane.kicad_sch (2022-05-10)

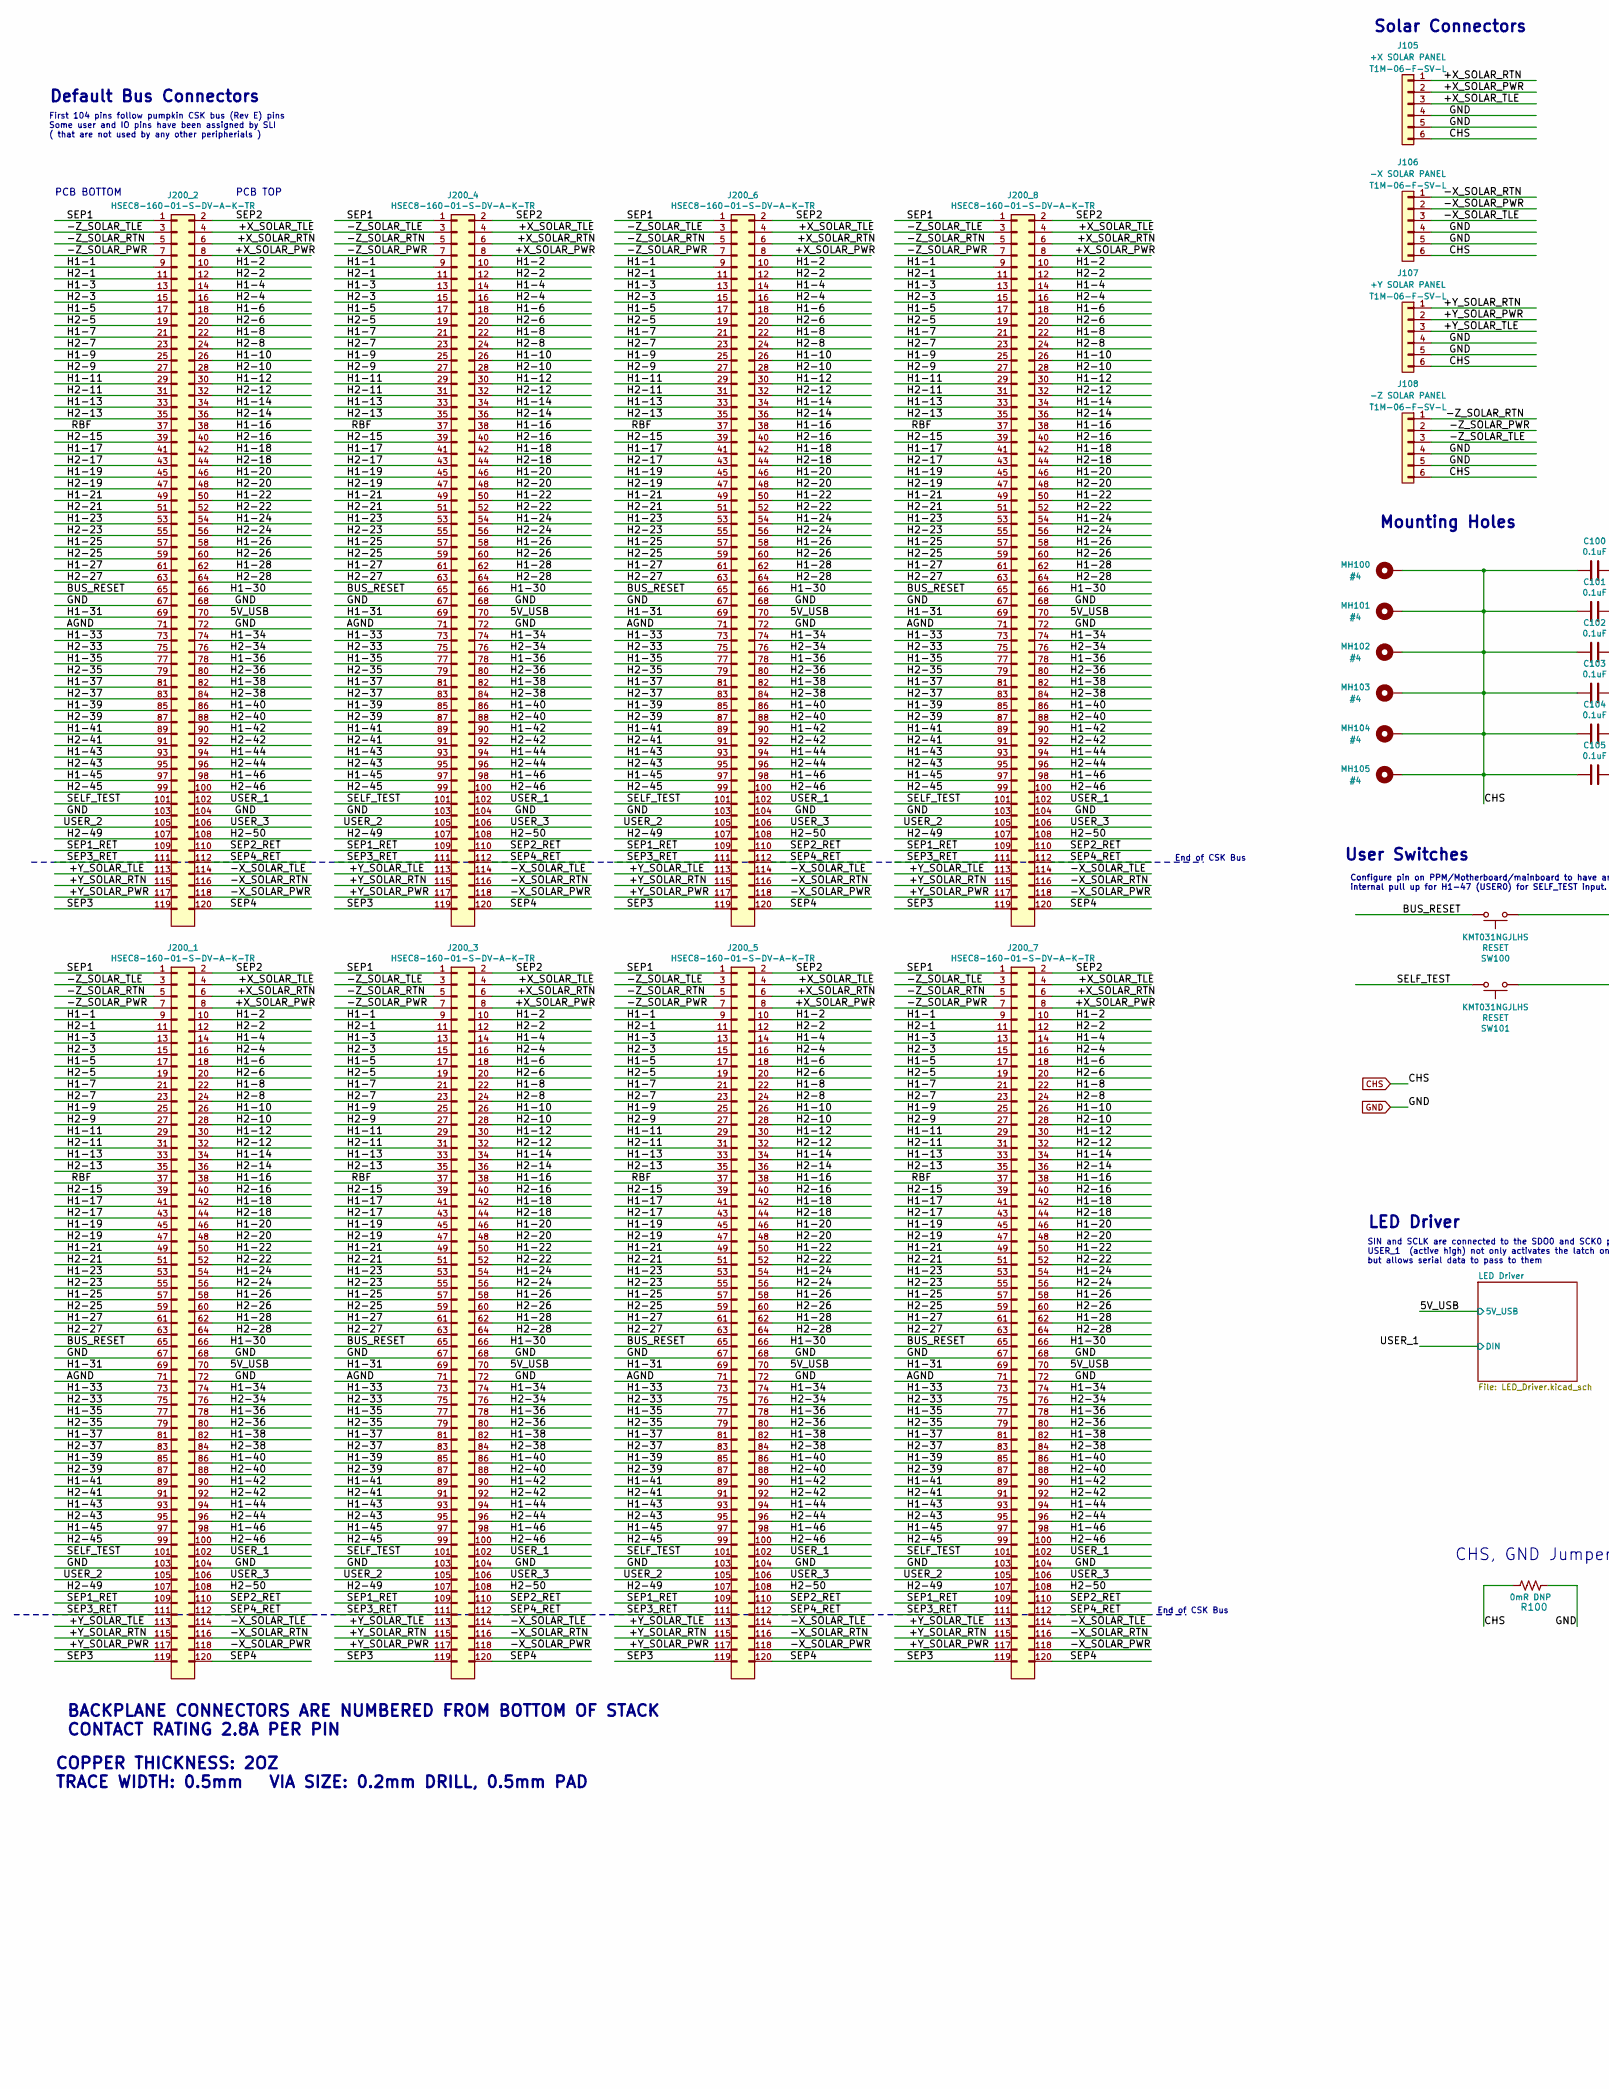
[picture p37: schematic backplane.kicad_sch, part in row 1, column 1]

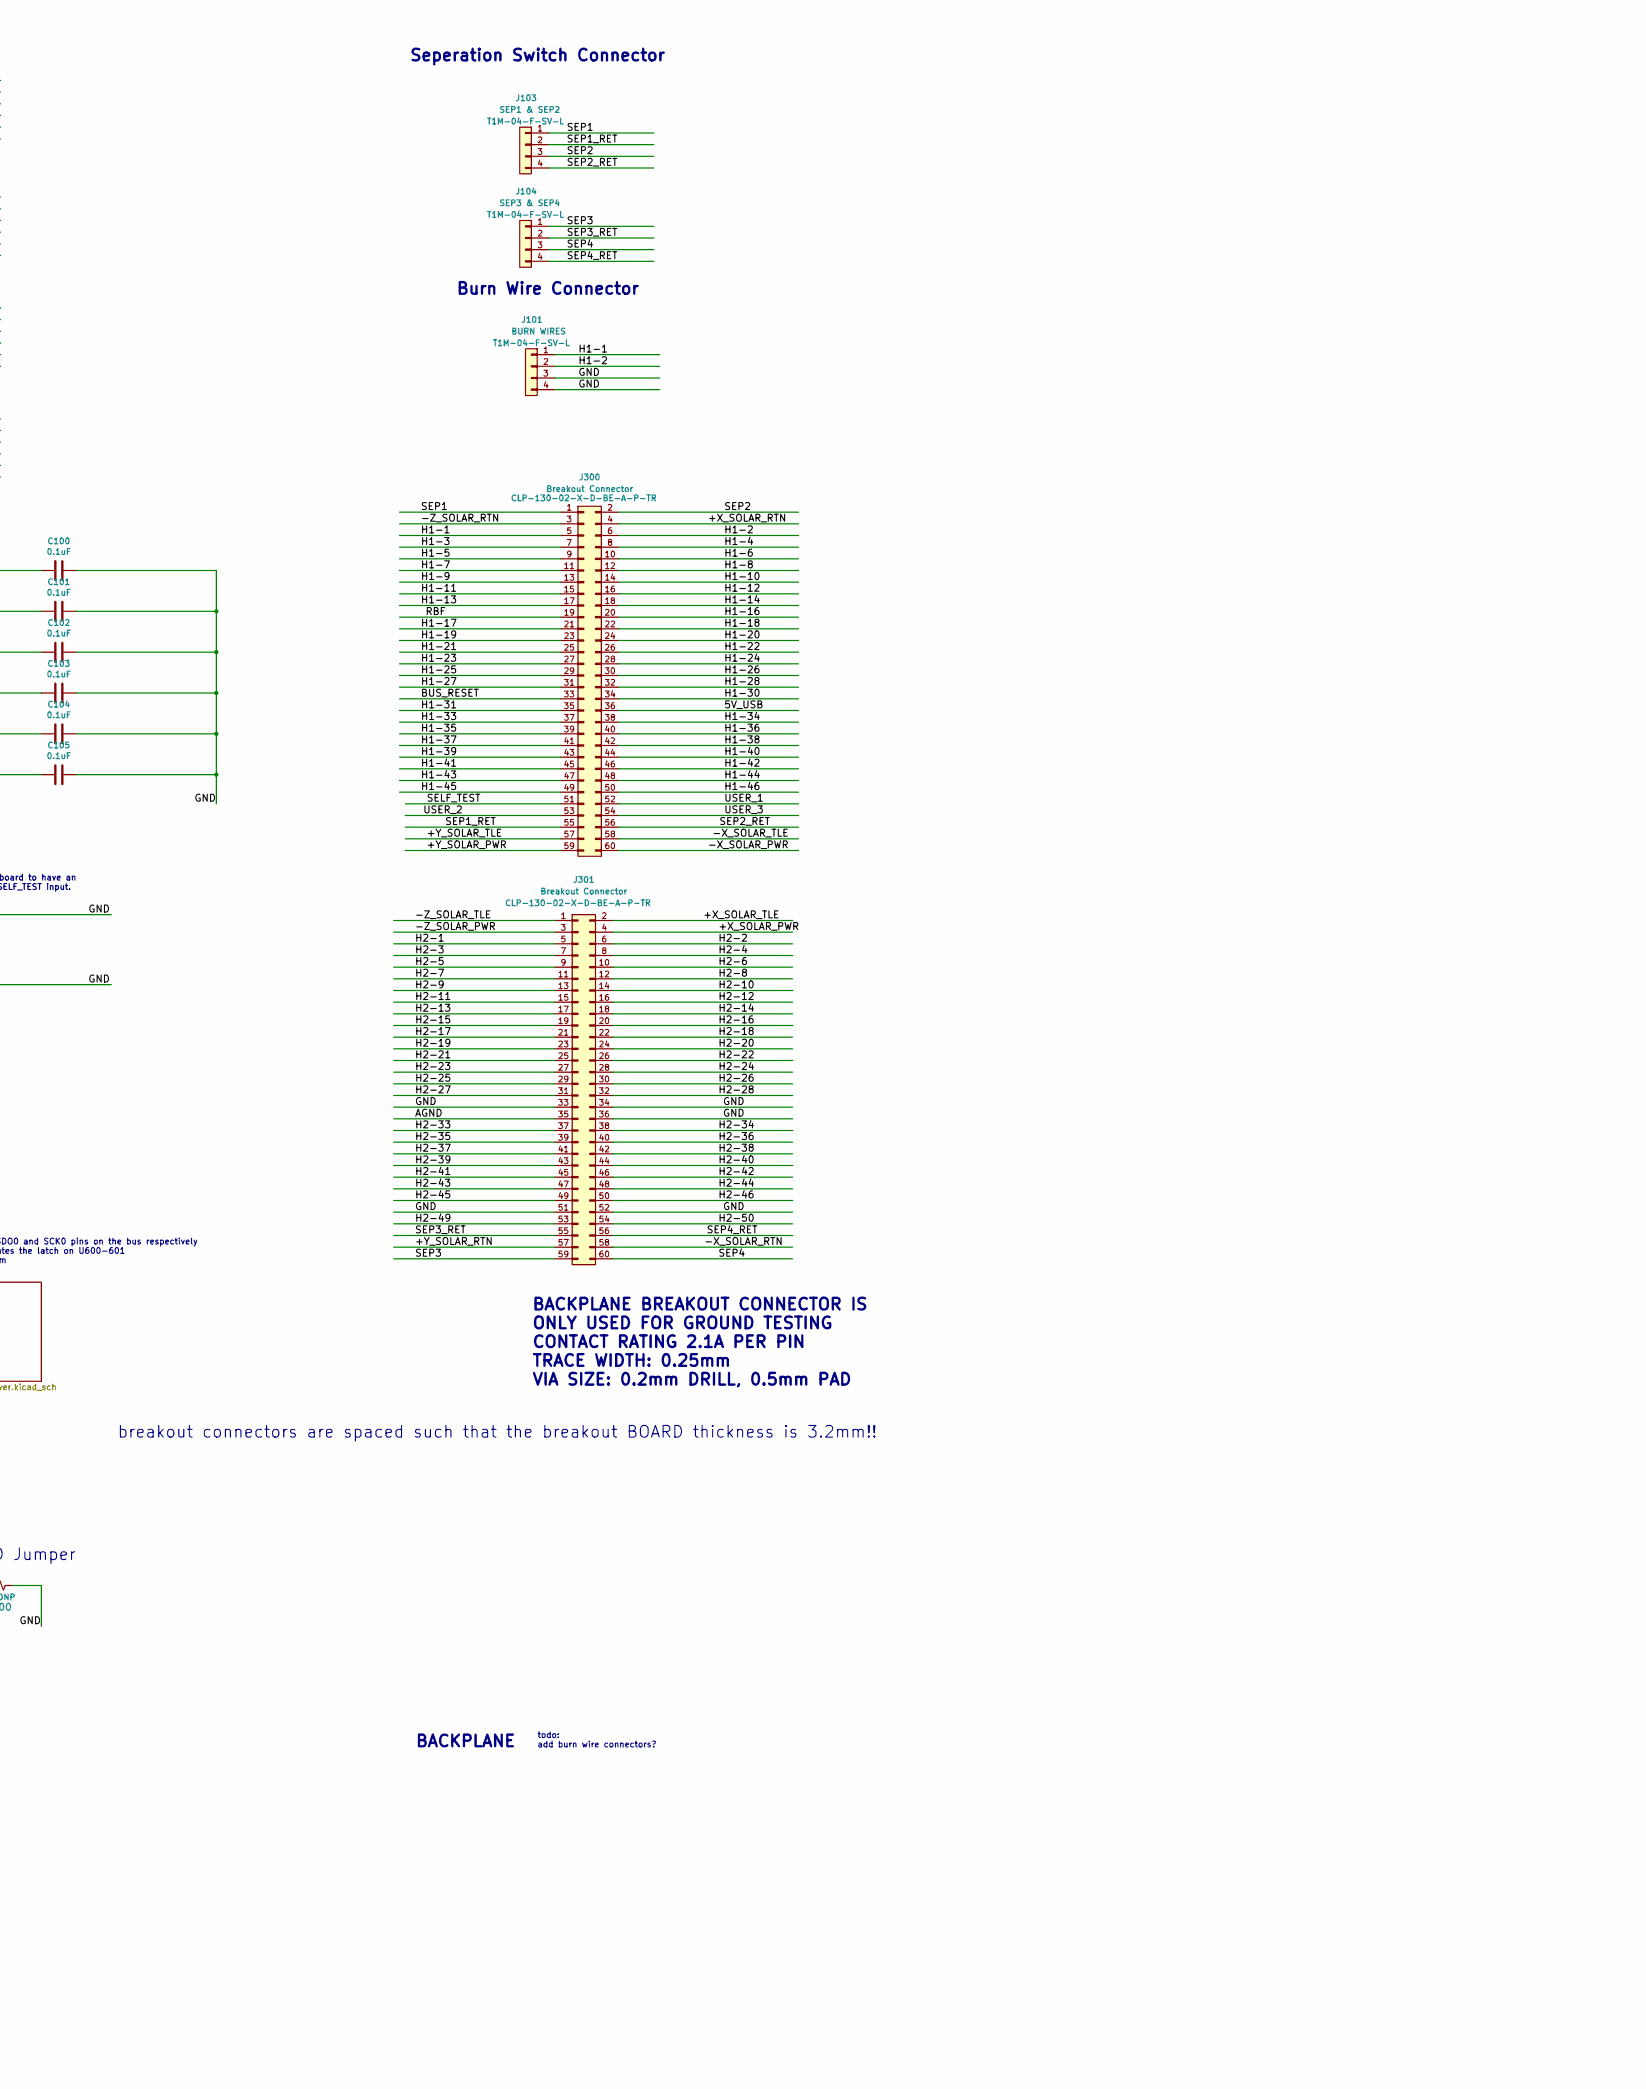
[picture p38: schematic backplane.kicad_sch, part in row 1, column 2]

Parts:
C100, C101, C102, C103, C104, C105: 0.1uF; C_0402_1005Metric; Manufacturer Part Numbe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 GRM155R71C104KA88D
J101: BURN WIRES; SAMTEC_T1M-04-F-SV-L
J103: SEP1 & SEP2; SAMTEC_T1M-04-F-SV-L
J104: SEP3 & SEP4; SAMTEC_T1M-04-F-SV-L
J105: +X SOLAR PANEL; SAMTEC_T1M-06-F-SV-L
J106: -X SOLAR PANEL; SAMTEC_T1M-06-F-SV-L
J107: +Y SOLAR PANEL; SAMTEC_T1M-06-F-SV-L
J108: -Z SOLAR PANEL; SAMTEC_T1M-06-F-SV-L
J200_1, J200_2, J200_3, J200_4, J200_5, J200_6, J200_7, J200_8: HSEC8-160-01-S-DV-A-K-TR; Manufacturer Part Numbe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 HSEC8-160-01-S-DV-A-K-TR
J300, J301: Breakout Connector; SAMTEC_CLP-130-02-X-D-BE-A-P-TR; Manufacturer Part Numbe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 CLP-130-02-X-D-BE-A-P-TR
MH100, MH101, MH102, MH103, MH104, MH105: #4; #4_PTH; Manufacturer Part Numbe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 #4 Socket Head
R100: 0mR DNP; R_0603_1608Metric; Manufacturer Part Numbe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 RC0603JR-070RL
SW100, SW101: RESET; KMT031_NGJ_LHS; Manufacturer Part Numbe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 KMT031NGJLHS

Connections:
5V_USB: J200_1.70, J200_2.70, J200_3.70, J200_4.70, J200_5.70, J200_6.70, J200_7.70, J200_8.70, J300.36
+X_SOLAR_PWR: J105.2, J200_1.8, J200_2.8, J200_3.8, J200_4.8, J200_5.8, J200_6.8, J200_7.8, J200_8.8, J301.4
+X_SOLAR_RTN: J105.1, J200_1.6, J200_2.6, J200_3.6, J200_4.6, J200_5.6, J200_6.6, J200_7.6, J200_8.6, J300.4
+X_SOLAR_TLE: J105.3, J200_1.4, J200_2.4, J200_3.4, J200_4.4, J200_5.4, J200_6.4, J200_7.4, J200_8.4, J301.2
+Y_SOLAR_PWR: J107.2, J200_1.117, J200_2.117, J200_3.117, J200_4.117, J200_5.117, J200_6.117, J200_7.117, J200_8.117, J300.59
+Y_SOLAR_RTN: J107.1, J200_1.115, J200_2.115, J200_3.115, J200_4.115, J200_5.115, J200_6.115, J200_7.115, J200_8.115, J301.57
+Y_SOLAR_TLE: J107.3, J200_1.113, J200_2.113, J200_3.113, J200_4.113, J200_5.113, J200_6.113, J200_7.113, J200_8.113, J300.57
-X_SOLAR_PWR: J106.2, J200_1.118, J200_2.118, J200_3.118, J200_4.118, J200_5.118, J200_6.118, J200_7.118, J200_8.118, J300.60
-X_SOLAR_RTN: J106.1, J200_1.116, J200_2.116, J200_3.116, J200_4.116, J200_5.116, J200_6.116, J200_7.116, J200_8.116, J301.58
-X_SOLAR_TLE: J106.3, J200_1.114, J200_2.114, J200_3.114, J200_4.114, J200_5.114, J200_6.114, J200_7.114, J200_8.114, J300.58
-Z_SOLAR_PWR: J108.2, J200_1.7, J200_2.7, J200_3.7, J200_4.7, J200_5.7, J200_6.7, J200_7.7, J200_8.7, J301.3
-Z_SOLAR_RTN: J108.1, J200_1.5, J200_2.5, J200_3.5, J200_4.5, J200_5.5, J200_6.5, J200_7.5, J200_8.5, J300.3
-Z_SOLAR_TLE: J108.3, J200_1.3, J200_2.3, J200_3.3, J200_4.3, J200_5.3, J200_6.3, J200_7.3, J200_8.3, J301.1
AGND: J200_1.71, J200_2.71, J200_3.71, J200_4.71, J200_5.71, J200_6.71, J200_7.71, J200_8.71, J301.35
BUS_RESET: J200_1.65, J200_2.65, J200_3.65, J200_4.65, J200_5.65, J200_6.65, J200_7.65, J200_8.65, J300.33, SW100.2
CHS: C100.2, C101.2, C102.2, C103.2, C104.2, C105.2, J105.6, J106.6, J107.6, J108.6, MH100.1, MH101.1, MH102.1, MH103.1, MH104.1, MH105.1, R100.2
GND: C100.1, C101.1, C102.1, C103.1, C104.1, C105.1, J101.3, J101.4, J105.4, J105.5, J106.4, J106.5, J107.4, J107.5, J108.4, J108.5, J200_1.67, J200_1.68, J200_1.72, J200_1.103, J200_1.104, J200_2.67, J200_2.68, J200_2.72, J200_2.103, J200_2.104, J200_3.67, J200_3.68, J200_3.72, J200_3.103, J200_3.104, J200_4.67, J200_4.68, J200_4.72, J200_4.103, J200_4.104, J200_5.67, J200_5.68, J200_5.72, J200_5.103, J200_5.104, J200_6.67, J200_6.68, J200_6.72, J200_6.103, J200_6.104, J200_7.67, J200_7.68, J200_7.72, J200_7.103, J200_7.104, J200_8.67, J200_8.68, J200_8.72, J200_8.103, J200_8.104, J301.33, J301.34, J301.36, J301.51, J301.52, R100.1, SW100.1, SW101.1
H1-1: J101.1, J200_1.9, J200_2.9, J200_3.9, J200_4.9, J200_5.9, J200_6.9, J200_7.9, J200_8.9, J300.5
H1-2: J101.2, J200_1.10, J200_2.10, J200_3.10, J200_4.10, J200_5.10, J200_6.10, J200_7.10, J200_8.10, J300.6
H1-3: J200_1.13, J200_2.13, J200_3.13, J200_4.13, J200_5.13, J200_6.13, J200_7.13, J200_8.13, J300.7
H1-4: J200_1.14, J200_2.14, J200_3.14, J200_4.14, J200_5.14, J200_6.14, J200_7.14, J200_8.14, J300.8
H1-5: J200_1.17, J200_2.17, J200_3.17, J200_4.17, J200_5.17, J200_6.17, J200_7.17, J200_8.17, J300.9
H1-6: J200_1.18, J200_2.18, J200_3.18, J200_4.18, J200_5.18, J200_6.18, J200_7.18, J200_8.18, J300.10
H1-7: J200_1.21, J200_2.21, J200_3.21, J200_4.21, J200_5.21, J200_6.21, J200_7.21, J200_8.21, J300.11
H1-8: J200_1.22, J200_2.22, J200_3.22, J200_4.22, J200_5.22, J200_6.22, J200_7.22, J200_8.22, J300.12
H1-9: J200_1.25, J200_2.25, J200_3.25, J200_4.25, J200_5.25, J200_6.25, J200_7.25, J200_8.25, J300.13
H1-10: J200_1.26, J200_2.26, J200_3.26, J200_4.26, J200_5.26, J200_6.26, J200_7.26, J200_8.26, J300.14
H1-11: J200_1.29, J200_2.29, J200_3.29, J200_4.29, J200_5.29, J200_6.29, J200_7.29, J200_8.29, J300.15
H1-12: J200_1.30, J200_2.30, J200_3.30, J200_4.30, J200_5.30, J200_6.30, J200_7.30, J200_8.30, J300.16
H1-13: J200_1.33, J200_2.33, J200_3.33, J200_4.33, J200_5.33, J200_6.33, J200_7.33, J200_8.33, J300.17
H1-14: J200_1.34, J200_2.34, J200_3.34, J200_4.34, J200_5.34, J200_6.34, J200_7.34, J200_8.34, J300.18
H1-16: J200_1.38, J200_2.38, J200_3.38, J200_4.38, J200_5.38, J200_6.38, J200_7.38, J200_8.38, J300.20
H1-17: J200_1.41, J200_2.41, J200_3.41, J200_4.41, J200_5.41, J200_6.41, J200_7.41, J200_8.41, J300.21
H1-18: J200_1.42, J200_2.42, J200_3.42, J200_4.42, J200_5.42, J200_6.42, J200_7.42, J200_8.42, J300.22
H1-19: J200_1.45, J200_2.45, J200_3.45, J200_4.45, J200_5.45, J200_6.45, J200_7.45, J200_8.45, J300.23
H1-20: J200_1.46, J200_2.46, J200_3.46, J200_4.46, J200_5.46, J200_6.46, J200_7.46, J200_8.46, J300.24
H1-21: J200_1.49, J200_2.49, J200_3.49, J200_4.49, J200_5.49, J200_6.49, J200_7.49, J200_8.49, J300.25
H1-22: J200_1.50, J200_2.50, J200_3.50, J200_4.50, J200_5.50, J200_6.50, J200_7.50, J200_8.50, J300.26
H1-23: J200_1.53, J200_2.53, J200_3.53, J200_4.53, J200_5.53, J200_6.53, J200_7.53, J200_8.53, J300.27
H1-24: J200_1.54, J200_2.54, J200_3.54, J200_4.54, J200_5.54, J200_6.54, J200_7.54, J200_8.54, J300.28
H1-25: J200_1.57, J200_2.57, J200_3.57, J200_4.57, J200_5.57, J200_6.57, J200_7.57, J200_8.57, J300.29
H1-26: J200_1.58, J200_2.58, J200_3.58, J200_4.58, J200_5.58, J200_6.58, J200_7.58, J200_8.58, J300.30
H1-27: J200_1.61, J200_2.61, J200_3.61, J200_4.61, J200_5.61, J200_6.61, J200_7.61, J200_8.61, J300.31
H1-28: J200_1.62, J200_2.62, J200_3.62, J200_4.62, J200_5.62, J200_6.62, J200_7.62, J200_8.62, J300.32
H1-30: J200_1.66, J200_2.66, J200_3.66, J200_4.66, J200_5.66, J200_6.66, J200_7.66, J200_8.66, J300.34
H1-31: J200_1.69, J200_2.69, J200_3.69, J200_4.69, J200_5.69, J200_6.69, J200_7.69, J200_8.69, J300.35
H1-33: J200_1.73, J200_2.73, J200_3.73, J200_4.73, J200_5.73, J200_6.73, J200_7.73, J200_8.73, J300.37
H1-34: J200_1.74, J200_2.74, J200_3.74, J200_4.74, J200_5.74, J200_6.74, J200_7.74, J200_8.74, J300.38
H1-35: J200_1.77, J200_2.77, J200_3.77, J200_4.77, J200_5.77, J200_6.77, J200_7.77, J200_8.77, J300.39
H1-36: J200_1.78, J200_2.78, J200_3.78, J200_4.78, J200_5.78, J200_6.78, J200_7.78, J200_8.78, J300.40
H1-37: J200_1.81, J200_2.81, J200_3.81, J200_4.81, J200_5.81, J200_6.81, J200_7.81, J200_8.81, J300.41
H1-38: J200_1.82, J200_2.82, J200_3.82, J200_4.82, J200_5.82, J200_6.82, J200_7.82, J200_8.82, J300.42
H1-39: J200_1.85, J200_2.85, J200_3.85, J200_4.85, J200_5.85, J200_6.85, J200_7.85, J200_8.85, J300.43
H1-40: J200_1.86, J200_2.86, J200_3.86, J200_4.86, J200_5.86, J200_6.86, J200_7.86, J200_8.86, J300.44
H1-41: J200_1.89, J200_2.89, J200_3.89, J200_4.89, J200_5.89, J200_6.89, J200_7.89, J200_8.89, J300.45
H1-42: J200_1.90, J200_2.90, J200_3.90, J200_4.90, J200_5.90, J200_6.90, J200_7.90, J200_8.90, J300.46
H1-43: J200_1.93 (Pin93), J200_2.93 (Pin93), J200_3.93 (Pin93), J200_4.93 (Pin93), J200_5.93 (Pin93), J200_6.93 (Pin93), J200_7.93 (Pin93), J200_8.93 (Pin93), J300.47
H1-44: J200_1.94, J200_2.94, J200_3.94, J200_4.94, J200_5.94, J200_6.94, J200_7.94, J200_8.94, J300.48
H1-45: J200_1.97, J200_2.97, J200_3.97, J200_4.97, J200_5.97, J200_6.97, J200_7.97, J200_8.97, J300.49
H1-46: J200_1.98, J200_2.98, J200_3.98, J200_4.98, J200_5.98, J200_6.98, J200_7.98, J200_8.98, J300.50
H2-1: J200_1.11, J200_2.11, J200_3.11, J200_4.11, J200_5.11, J200_6.11, J200_7.11, J200_8.11, J301.5
H2-2: J200_1.12, J200_2.12, J200_3.12, J200_4.12, J200_5.12, J200_6.12, J200_7.12, J200_8.12, J301.6
H2-3: J200_1.15, J200_2.15, J200_3.15, J200_4.15, J200_5.15, J200_6.15, J200_7.15, J200_8.15, J301.7
H2-4: J200_1.16, J200_2.16, J200_3.16, J200_4.16, J200_5.16, J200_6.16, J200_7.16, J200_8.16, J301.8
H2-5: J200_1.19, J200_2.19, J200_3.19, J200_4.19, J200_5.19, J200_6.19, J200_7.19, J200_8.19, J301.9
H2-6: J200_1.20, J200_2.20, J200_3.20, J200_4.20, J200_5.20, J200_6.20, J200_7.20, J200_8.20, J301.10
H2-7: J200_1.23, J200_2.23, J200_3.23, J200_4.23, J200_5.23, J200_6.23, J200_7.23, J200_8.23, J301.11
H2-8: J200_1.24, J200_2.24, J200_3.24, J200_4.24, J200_5.24, J200_6.24, J200_7.24, J200_8.24, J301.12
H2-9: J200_1.27, J200_2.27, J200_3.27, J200_4.27, J200_5.27, J200_6.27, J200_7.27, J200_8.27, J301.13
H2-10: J200_1.28, J200_2.28, J200_3.28, J200_4.28, J200_5.28, J200_6.28, J200_7.28, J200_8.28, J301.14
H2-11: J200_1.31, J200_2.31, J200_3.31, J200_4.31, J200_5.31, J200_6.31, J200_7.31, J200_8.31, J301.15
H2-12: J200_1.32, J200_2.32, J200_3.32, J200_4.32, J200_5.32, J200_6.32, J200_7.32, J200_8.32, J301.16
H2-13: J200_1.35, J200_2.35, J200_3.35, J200_4.35, J200_5.35, J200_6.35, J200_7.35, J200_8.35, J301.17
H2-14: J200_1.36, J200_2.36, J200_3.36, J200_4.36, J200_5.36, J200_6.36, J200_7.36, J200_8.36, J301.18
H2-15: J200_1.39, J200_2.39, J200_3.39, J200_4.39, J200_5.39, J200_6.39, J200_7.39, J200_8.39, J301.19
H2-16: J200_1.40, J200_2.40, J200_3.40, J200_4.40, J200_5.40, J200_6.40, J200_7.40, J200_8.40, J301.20
H2-17: J200_1.43, J200_2.43, J200_3.43, J200_4.43, J200_5.43, J200_6.43, J200_7.43, J200_8.43, J301.21
H2-18: J200_1.44, J200_2.44, J200_3.44, J200_4.44, J200_5.44, J200_6.44, J200_7.44, J200_8.44, J301.22
H2-19: J200_1.47, J200_2.47, J200_3.47, J200_4.47, J200_5.47, J200_6.47, J200_7.47, J200_8.47, J301.23
H2-20: J200_1.48, J200_2.48, J200_3.48, J200_4.48, J200_5.48, J200_6.48, J200_7.48, J200_8.48, J301.24
H2-21: J200_1.51, J200_2.51, J200_3.51, J200_4.51, J200_5.51, J200_6.51, J200_7.51, J200_8.51, J301.25
H2-22: J200_1.52, J200_2.52, J200_3.52, J200_4.52, J200_5.52, J200_6.52, J200_7.52, J200_8.52, J301.26
H2-23: J200_1.55, J200_2.55, J200_3.55, J200_4.55, J200_5.55, J200_6.55, J200_7.55, J200_8.55, J301.27
H2-24: J200_1.56, J200_2.56, J200_3.56, J200_4.56, J200_5.56, J200_6.56, J200_7.56, J200_8.56, J301.28
H2-25: J200_1.59, J200_2.59, J200_3.59, J200_4.59, J200_5.59, J200_6.59, J200_7.59, J200_8.59, J301.29
H2-26: J200_1.60, J200_2.60, J200_3.60, J200_4.60, J200_5.60, J200_6.60, J200_7.60, J200_8.60, J301.30
H2-27: J200_1.63, J200_2.63, J200_3.63, J200_4.63, J200_5.63, J200_6.63, J200_7.63, J200_8.63, J301.31
H2-28: J200_1.64, J200_2.64, J200_3.64, J200_4.64, J200_5.64, J200_6.64, J200_7.64, J200_8.64, J301.32
H2-33: J200_1.75, J200_2.75, J200_3.75, J200_4.75, J200_5.75, J200_6.75, J200_7.75, J200_8.75, J301.37
H2-34: J200_1.76, J200_2.76, J200_3.76, J200_4.76, J200_5.76, J200_6.76, J200_7.76, J200_8.76, J301.38
H2-35: J200_1.79, J200_2.79, J200_3.79, J200_4.79, J200_5.79, J200_6.79, J200_7.79, J200_8.79, J301.39
H2-36: J200_1.80, J200_2.80, J200_3.80, J200_4.80, J200_5.80, J200_6.80, J200_7.80, J200_8.80, J301.40
H2-37: J200_1.83, J200_2.83, J200_3.83, J200_4.83, J200_5.83, J200_6.83, J200_7.83, J200_8.83, J301.41
H2-38: J200_1.84, J200_2.84, J200_3.84, J200_4.84, J200_5.84, J200_6.84, J200_7.84, J200_8.84, J301.42
H2-39: J200_1.87, J200_2.87, J200_3.87, J200_4.87, J200_5.87, J200_6.87, J200_7.87, J200_8.87, J301.43
H2-40: J200_1.88, J200_2.88, J200_3.88, J200_4.88, J200_5.88, J200_6.88, J200_7.88, J200_8.88, J301.44
H2-41: J200_1.91, J200_2.91, J200_3.91, J200_4.91, J200_5.91, J200_6.91, J200_7.91, J200_8.91, J301.45
H2-42: J200_1.92, J200_2.92, J200_3.92, J200_4.92, J200_5.92, J200_6.92, J200_7.92, J200_8.92, J301.46
H2-43: J200_1.95, J200_2.95, J200_3.95, J200_4.95, J200_5.95, J200_6.95, J200_7.95, J200_8.95, J301.47
H2-44: J200_1.96, J200_2.96, J200_3.96, J200_4.96, J200_5.96, J200_6.96, J200_7.96, J200_8.96, J301.48
H2-45: J200_1.99, J200_2.99, J200_3.99, J200_4.99, J200_5.99, J200_6.99, J200_7.99, J200_8.99, J301.49
H2-46: J200_1.100, J200_2.100, J200_3.100, J200_4.100, J200_5.100, J200_6.100, J200_7.100, J200_8.100, J301.50
H2-49: J200_1.107, J200_2.107, J200_3.107, J200_4.107, J200_5.107, J200_6.107, J200_7.107, J200_8.107, J301.53
H2-50: J200_1.108, J200_2.108, J200_3.108, J200_4.108, J200_5.108, J200_6.108, J200_7.108, J200_8.108, J301.54
RBF: J200_1.37, J200_2.37, J200_3.37, J200_4.37, J200_5.37, J200_6.37, J200_7.37, J200_8.37, J300.19
SELF_TEST: J200_1.101, J200_2.101, J200_3.101, J200_4.101, J200_5.101, J200_6.101, J200_7.101, J200_8.101, J300.51, SW101.2
SEP1: J103.1, J200_1.1, J200_2.1, J200_3.1, J200_4.1, J200_5.1, J200_6.1, J200_7.1, J200_8.1, J300.1
SEP1_RET: J103.2, J200_1.109, J200_2.109, J200_3.109, J200_4.109, J200_5.109, J200_6.109, J200_7.109, J200_8.109, J300.55
SEP2: J103.3, J200_1.2, J200_2.2, J200_3.2, J200_4.2, J200_5.2, J200_6.2, J200_7.2, J200_8.2, J300.2
SEP2_RET: J103.4, J200_1.110, J200_2.110, J200_3.110, J200_4.110, J200_5.110, J200_6.110, J200_7.110, J200_8.110, J300.56
SEP3: J104.1, J200_1.119, J200_2.119, J200_3.119, J200_4.119, J200_5.119, J200_6.119, J200_7.119, J200_8.119, J301.59
SEP3_RET: J104.2, J200_1.111, J200_2.111, J200_3.111, J200_4.111, J200_5.111, J200_6.111, J200_7.111, J200_8.111, J301.55
SEP4: J104.3, J200_1.120, J200_2.120, J200_3.120, J200_4.120, J200_5.120, J200_6.120, J200_7.120, J200_8.120, J301.60
SEP4_RET: J104.4, J200_1.112, J200_2.112, J200_3.112, J200_4.112, J200_5.112, J200_6.112, J200_7.112, J200_8.112, J301.56
USER_1: J200_1.102, J200_2.102, J200_3.102, J200_4.102, J200_5.102, J200_6.102, J200_7.102, J200_8.102, J300.52
USER_2: J200_1.105, J200_2.105, J200_3.105, J200_4.105, J200_5.105, J200_6.105, J200_7.105, J200_8.105, J300.53
USER_3: J200_1.106, J200_2.106, J200_3.106, J200_4.106, J200_5.106, J200_6.106, J200_7.106, J200_8.106, J300.54

Notes on the sheet:
BACKPLANE CONNECTORS ARE NUMBERED FROM BOTTOM OF STACK CONTACT RATING 2.8A PER PIN
todo: add burn wire connectors?
SIN and SCLK are connected to the SDO0 and SCK0 pins on the bus respectively USER_1 (active high) not only activates the latch on U600-601 but allows serial data to pass to them
End of CSK Bus
Solar Connectors
breakout connectors are spaced such that the breakout BOARD thickness is 3.2mm!!
Seperation Switch Connector
Default Bus Connectors
PCB BOTTOM
Burn Wire Connector
First 104 pins follow pumpkin CSK bus (Rev E) pins Some user and IO pins have been assigned by SLI ( that are not used by any other peripherials )
COPPER THICKNESS: 2OZ TRACE WIDTH: 0.5mm VIA SIZE: 0.2mm DRILL, 0.5mm PAD
BACKPLANE BREAKOUT CONNECTOR IS ONLY USED FOR GROUND TESTING CONTACT RATING 2.1A PER PIN TRACE WIDTH: 0.25mm VIA SIZE: 0.2mm DRILL, 0.5mm PAD
Configure pin on PPM/Motherboard/mainboard to have an internal pull up for H1-47 (USER0) for SELF_TEST input.
CHS, GND Jumper
User Switches
PCB TOP
LED Driver
BACKPLANE
Mounting Holes
