Sierra-Lobo/backplane/(commit log)

2021-12-10 kicad files init commit
    [CubeSat_Backplane.step, LED_Driver.sch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]
2021-12-10 Add files via upload
    initial revA1
    [CubeSat_Backplane.step, LED_Driver.sch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]
2021-12-17 final changes before ordering
    [backplane-B_Cu.gbl, backplane-B_Mask.gbs, backplane-B_SilkS.gbo, backplane-Edge_Cuts.gm1, backplane-F_Cu.gtl, backplane-F_Mask.gts, backplane-F_SilkS.gto, backplane-NPTH.drl]
2021-12-17 adding project files for adapter boards
    [backplane-breakout-headers.kicad_pcb, backplane-breakout-headers.sch, backplane-breakout-tp.kicad_pcb, backplane-breakout-tp.sch, backplane-rbf.kicad_pcb, backplane-rbf.sch, backplane-sepsw.kicad_pcb, backplane-sepsw.sch]
2021-12-18 changed breakout connector
    [backplane-B_Cu.gbl, backplane-B_Mask.gbs, backplane-B_SilkS.gbo, backplane-Edge_Cuts.gm1, backplane-F_Cu.gtl, backplane-F_Mask.gts, backplane-F_SilkS.gto, backplane-NPTH.drl]
2021-12-18 fab data for new connector
    [backplane-pcbway-121821.xlsx]
2021-12-19 backplane sepsw emulator board
    [backplane-rbf-B_Cu.gbl, backplane-rbf-B_Mask.gbs, backplane-rbf-B_Paste.gbp, backplane-rbf-B_SilkS.gbo, backplane-rbf-Edge_Cuts.gm1, backplane-rbf-F_Cu.gtl, backplane-rbf-F_Mask.gts, backplane-rbf-F_Paste.gtp]
2021-12-19 made backplane breakout fpc
    [LED_Driver.sch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]
2021-12-20 changed to 2x30 1.27mm headers
    [backplane.sch]
2021-12-21 8mil/8mil trace/space
    [backplane-B_Cu.gbl, backplane-B_Mask.gbs, backplane-B_SilkS.gbo, backplane-Edge_Cuts.gm1, backplane-F_Cu.gtl, backplane-F_Mask.gts, backplane-F_SilkS.gto, backplane-NPTH.drl]
2021-12-21 breakout connector
    [SAMTEC-FTS-130-03-X-DV.step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]
2021-12-21 fab files to pcbway
    [backplane_bom-122121.xlsx]
2021-12-22 tested rbf fit
    [CubeSat_Backplane.step, backplane-rbf.kicad_pcb, backplane-rbf.step]
2021-12-27 pcbway eng ?s
    [W422300AS1J11.xls, backplane-pcbway-121721.xlsx, backplane-pcbway-121821.xlsx, backplane_bom-122121.xlsx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]
2022-01-03 routed more
    [backplane-breaout-big.kicad_sch]
2022-01-04 updated .pos files for fabrication
    [backplane-bottom-pos.csv, backplane-top-pos.csv]
2022-01-04 completion push
    [backplane-breaout-big.csv, backplane-breaout-big.kicad_sch]
2022-01-05 fab files generated 2 pcbway
    [backplane-breaout-big-B_Cu.gbl, backplane-breaout-big-B_Mask.gbs, backplane-breaout-big-B_Paste.gbp, backplane-breaout-big-B_Silkscreen.gbo, backplane-breaout-big-Edge_Cuts.gm1, backplane-breaout-big-F_Cu.gtl, backplane-breaout-big-F_Mask.gts, backplane-breaout-big-F_Paste.gtp]
2022-01-06 Create Copy of T-1J26W422300A-2sets-backplane-breaout-big-bom(2022-01-06).xls
    [Copy of T-1J26W422300A-2sets-backplane-breaout-big-bom(2022-01-06).xls]
2022-01-25 minor bom issues corrected
    [backplane-breaout-big.xlsx]
2022-02-23 bom change
    [backplane_bom.xlsx]
2022-02-23 rearranged folders
    [Copy of T-1J26W422300A-2sets-backplane-breaout-big-bom(2022-01-06).xls, LED_Driver.sch, SAMTEC-FTS-130-03-X-DV.step, W422300AS1J11.xls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]
2022-05-10 revC FM
    [LED_Driver.kicad_sch, SAMTEC-FTS-130-03-X-DV.step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]
2022-05-12 corrected gerbers for FM
    [PCBway-TZ28W422300A-2sets-backplane_bom(2022-05-12).xls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]
2022-05-19 updated fab notes
    [AA B110353 ER.xlsx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]
2022-09-09 updated RBF to correct pin
    [backplane-rbf.kicad_pcb, backplane-rbf.kicad_sch]
2023-01-12 init breakout commit
    [LED.kicad_sch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]
2023-01-13 updated silk screen, bom, and sub J301.
    [breakout-B_Cu.gbr, breakout-B_Mask.gbr, breakout-B_Paste.gbr, breakout-B_Silkscreen.gbr, breakout-Edge_Cuts.gbr, breakout-F_Cu.gbr, breakout-F_Mask.gbr, breakout-F_Paste.gbr]
2023-01-24 Fixed pinout of solar panel connectors on backplane
    pinout didnt match solar panels. pins 7 and 8 on solar panels aren't used. pin 7 is an extra tlm connection, pin 8 is an extra chs connection.
    [backplane.kicad_sch]
2023-03-16 added rbf_ret net, added capability for neopixels on BP cards, added jumpers to bypass this
    [LED_Driver.kicad_sch, backplane.kicad_sch]
2023-03-21 renamed rev folders
    [AA B110353 ER.xlsx, LED_Driver.kicad_sch, LED_Driver.sch, PCBway-TZ28W422300A-2sets-backplane_bom(2022-05-12).xls, SAMTEC-FTS-130-03-X-DV.step, W422300AS1J11.xls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]
2023-03-22 moved /breakout-big to separate repo
    [Copy of T-1J26W422300A-2sets-backplane-breaout-big-bom(2022-01-06).xls, LED_Driver.sch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]
2023-03-22 moved backplane-rbf to its own repo
    [backplane-rbf-B_Cu.gbl, backplane-rbf-B_Mask.gbs, backplane-rbf-B_SilkS.gbo, backplane-rbf-Edge_Cuts.gm1, backplane-rbf-F_Cu.gtl, backplane-rbf-F_Mask.gts, backplane-rbf-F_SilkS.gto, backplane-rbf-NPTH.drl]
2023-03-22 moved breakout to its own repo
    [AA B110353 ER.xlsx, LED.kicad_sch, LED_Driver.kicad_sch, LED_Driver.sch, PCBway-TZ28W422300A-2sets-backplane_bom(2022-05-12).xls, SAMTEC-FTS-130-03-X-DV.step, W422300AS1J11.xls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]
2023-03-24 updated layout for fm.
    [LED_Driver.kicad_sch, backplane.kicad_sch]
2023-03-24 removed old files
    [AA B110353 ER.xlsx, LED_Driver.kicad_sch, PCBway-TZ28W422300A-2sets-backplane_bom(2022-05-12).xls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]
2023-05-30 working post-review changes
    [LED_Driver.kicad_sch, backplane.kicad_sch]
2023-05-31 revC commit
    [LED_Driver.kicad_sch, SAMTEC-FTS-130-03-X-DV.step, backplane.kicad_sch, backplane_bom.xlsx]
2023-06-01 generated fab files
    [backplane-B_Cu.gbl, backplane-B_Mask.gbs, backplane-B_Silkscreen.gbo, backplane-Edge_Cuts.gm1, backplane-F_Cu.gtl, backplane-F_Mask.gts, backplane-F_Silkscreen.gto, backplane-NPTH-drl_map.gbr]
2023-06-01 added some datasheets
    [backplane.kicad_sch]
2023-06-08 bom updated
    [backplane_bom.xlsx, bom.xlsx]
2023-06-22 retrieved original revC, latest is now C1
    [AA B110353 ER.xlsx, LED_Driver.kicad_sch, PCBway-TZ28W422300A-2sets-backplane_bom(2022-05-12).xls, SAMTEC-FTS-130-03-X-DV.step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]
