Sierra-Lobo/backplane/(notices)

Notices in the files:
revB/solid models/SAMTEC-FTS-130-03-X-DV.step:
FILE_NAME( 'e:/temp/worker_61/temp/exporttempdir_2976_1726_jvh3T/format_0/FTS-130-03-L-DV.stp', '2021-12-21T18:41:20', ( 'License CC BY-ND 4.0' ), ( 'CADENAS' ), ' ', 'PARTsolutions', ' ' );
